imissyou6534/cheshire/docs/current_soc_architecture_report.html

# Cheshire CVA6 + Ara + FFT / VCU118 SoC 架构与地址空间分析

分析对象：/home/user06/work/xinkailai/cheshire，分支 ara-vcu118，当前工作区包含未提交的 FFT/VCU118 相关改动。

生成日期：2026-10-03。本文只基于当前源码与已生成脚本做静态分析；没有修改 RTL、C 源码或构建脚本。

## 1. 结论摘要

### SoC 主体

顶层 SoC 是 hw/cheshire_soc.sv。它以 CVA6 为核心，通过一个主 AXI crossbar 连接调试模块、LLC/SPM、DMA、Ara、FFT、VGA/USB 等 AXI master 或 slave，再通过 AXI-to-Regbus 适配器访问低速外设。

### VCU118 封装

板级顶层是 target/xilinx/src/cheshire_top_xilinx.sv。VCU118 打开 DDR4、JTAG、QSPI/STARTUPE3、VIO 和 reset；DDR4 通过 dram_wrapper_xilinx.sv 接到 SoC 的 LLC 外部 AXI master 端口。

### 地址分配

地址空间由 hw/cheshire_pkg.sv 中的 gen_axi_out() 和 gen_reg_out() 生成；实际译码在 hw/cheshire_soc.sv 的 axi_xbar 与 addr_decode + reg_demux 中完成。

### FFT 集成方式

FFT 不是 MMIO 外设，没有单独寄存器窗口。它复用 CVA6 的 accelerator/CVXIF 类接口，与 Ara 通过 multi_accel_router 按指令 opcode 分流，并作为独立 AXI master 访问现有内存地址。

当前构建脚本状态：target/xilinx/scripts/add_sources.vcu118.tcl 当前定义了 ARA、NR_LANES=2、VLEN=2048，但没有定义 FFT_ACCEL。源码已经有 Cfg.Fft、FFT RTL 和路由逻辑；若要在 VCU118 bitstream 中实际实例化 FFT，需要确保构建时带上 FFT_ACCEL 宏并重新生成/使用对应 Vivado source script。

## 2. 当前 VCU118 配置来源

配置链路如下：

1. hw/cheshire_pkg.sv 定义 cheshire_cfg_t、DefaultCfg、地址常量和地址映射函数。
2. target/xilinx/src/cheshire_top_xilinx.sv 的 gen_cheshire_xilinx_cfg() 从 DefaultCfg 复制配置，并针对 FPGA 覆盖少量参数。
3. target/xilinx/src/phy_definitions.svh 根据 TARGET_VCU118 打开板级 IO 宏。
4. cheshire_soc #(.Cfg(FPGACfg)) 接收最终配置，内部生成 AXI/Regbus 端口数量和地址规则。

### 2.1 FPGA 顶层覆盖项

项目 | 当前值/行为 | 定义位置 | 说明
RTC | RtcFreq = 1_000_000 | cheshire_top_xilinx.sv | 50 MHz SoC 时钟分频得到 1 MHz RTC。
Serial Link | SerialLink = 0 | cheshire_top_xilinx.sv | 默认配置中打开，但 Xilinx 顶层显式关闭。
USB | VCU118 下通常为 0 | phy_definitions.svh + cheshire_top_xilinx.sv | 只有定义 USE_USB 时才置 ret.Usb = 1；VCU118 宏未定义 USE_USB。
Ara | 由 ARA 宏控制 | cheshire_top_xilinx.sv | 当前生成的 VCU118 source script 已定义 ARA。
Ara 参数 | NR_LANES=2, VLEN=2048 | add_sources.vcu118.tcl | 这些宏传入 AraNrLanes 和 AraVLEN。
FFT | 由 FFT_ACCEL 宏控制 | cheshire_top_xilinx.sv | 源码支持 ret.Fft = 1；当前已生成 VCU118 tcl 尚未带此宏。

### 2.2 VCU118 板级 IO 宏

target/xilinx/src/phy_definitions.svh 对 TARGET_VCU118 定义：

`define USE_RESET
`define USE_JTAG
`define USE_DDR4
`define USE_QSPI
`define USE_STARTUPE3
`define USE_VIO

这表示板级已接出 reset、JTAG、DDR4、QSPI flash 访问路径和 VIO。I2C、SD、VGA、USB、fan 等宏没有在 VCU118 分支中打开。注意：这不等同于 SoC 内部外设配置全部关闭；例如 DefaultCfg 仍默认开启 I2C、GPIO、VGA，除非 FPGA 配置函数覆盖。

## 3. SoC 结构

### 3.1 高层数据通路

CVA6 core
  |-- AXI master ---------------------------------------------.
  |                                                           |
  |-- accelerator request --> multi_accel_router --> Ara ---- | --> AXI master
                         |                     \              |
                         `--------------------> FFT accel ----'

Debug SBA / DMA / VGA / USB / external AXI masters --------------> AXI xbar

AXI xbar outputs:
  [0] Debug Module AXI slave
  [1] AXI-to-Regbus adapter -> Reg demux -> CLINT/PLIC/UART/SPI/GPIO/...
  [2] LLC/SPM/DRAM path
  [3] DMA config AXI slave
  [external] optional AXI subordinate ports

LLC master output -> Xilinx DDR4 wrapper -> VCU118 DDR4 MIG

### 3.2 关键模块职责

模块/文件 | 职责 | 与地址空间关系
hw/cheshire_pkg.sv | 配置结构、默认配置、静态地址常量、AXI/Regbus 端口和规则生成函数。 | 地址分配的单一核心来源。
hw/cheshire_soc.sv | SoC 顶层，实例化 AXI crossbar、Regbus demux、CVA6、Ara、FFT、调试模块、外设。 | 把 AxiMap 接到 axi_xbar，把 RegMap 接到 addr_decode。
target/xilinx/src/cheshire_top_xilinx.sv | Xilinx/VCU118 顶层封装，产生时钟/reset，连接 DDR、JTAG、UART、QSPI 等板级 IO。 | 不重新定义 SoC 地址，只选择配置和连接外部 DRAM。
target/xilinx/src/dram_wrapper_xilinx.sv | Xilinx DDR3/DDR4 MIG AXI 包装。 | 接收 SoC 的 axi_llc_mst_req_o，承载 0x8000_0000..0x1_0000_0000 DRAM 区域。
hw/fft/src/*.sv | FFT 指令识别、Ara/FFT 请求路由、FFT 任务控制、AXI 读写桥和 FFT core 包装。 | 无 MMIO 窗口；通过 AXI master 对已有内存区域读写。
sw/link/common.ldh | 裸机软件的 linker 地址符号。 | 定义 __base_uart、__base_spm、__base_dram 等软件可见基址。

## 4. 地址空间如何分配

### 4.1 分配机制

Cheshire 的地址分配不是散落在外设实例化处手写的，而是由配置结构生成：

层级 | 函数/模块 | 输入 | 输出
AXI crossbar 输入端口 | gen_axi_in(Cfg) | 哪些 AXI manager 启用：core、debug、Ara、FFT、DMA、VGA、USB、external masters | AxiIn.* 端口编号
AXI crossbar 输出端口和规则 | gen_axi_out(Cfg) | LLC/SPM/DRAM/DMA/SerialLink/external rules | AxiOut.* 端口编号与 AxiMap
Regbus demux 输出端口和规则 | gen_reg_out(Cfg) | Boot ROM、CLINT、PLIC、UART、I2C、SPI、GPIO、VGA、BusErr 等开关 | RegOut.* 端口编号与 RegMap
实际译码 | axi_xbar, addr_decode, reg_demux | AxiMap, RegMap | 把访问请求送到具体 slave；Regbus 未命中进 error slave。

地址规则是半开区间：源码中用 start 和 pte/end_addr 表示 [start, end)。例如 0x0300_2000..0x0300_3000 是 4 KiB UART 窗口。

### 4.2 顶层 AXI 地址映射

以下按当前 VCU118 配置理解；若 FFT_ACCEL 打开，只增加 AXI manager 输入端口，不增加新的地址窗口。

地址范围 | 大小 | AXI 输出端口 | 目标 | 定义来源
0x0000_0000 .. 0x0004_0000 | 256 KiB | AxiOut.dbg | RISC-V Debug Module ROM/register/SBA slave | gen_axi_out(), AmDbg
0x0100_0000 .. 0x0100_1000 | 4 KiB | AxiOut.dma | iDMA 配置 slave | gen_axi_out()
0x0200_0000 .. 0x0c00_0000 | 160 MiB | AxiOut.reg_demux | AXI-to-Regbus 适配器，再二级译码到 Regbus 外设 | gen_axi_out()
0x1000_0000 .. 0x1002_0000 | 128 KiB | AxiOut.spm/AxiOut.llc | LLC scratchpad cached alias | get_llc_size(DefaultCfg)
0x1400_0000 .. 0x1402_0000 | 128 KiB | AxiOut.spm/AxiOut.llc | LLC scratchpad uncached alias | AmSpm + 0x0400_0000
0x8000_0000 .. 0x1_0000_0000 | 2 GiB | AxiOut.llc | LLC outgoing DRAM region，VCU118 接 DDR4 MIG | LlcOutRegionStart/End

文档与当前配置的差异：上游 docs/um/arch.md 用概念表描述 SPM 为 64 MiB cached + 64 MiB uncached；当前 DefaultCfg 的 LLC 参数计算得到实际内部 SPM 大小为 128 KiB，因此硬件 map 为 0x1000_0000..0x1002_0000 和 0x1400_0000..0x1402_0000。

### 4.3 Regbus 二级地址映射

地址范围 | 大小 | Regbus 端口 | 外设/模块 | 当前 VCU118 状态
0x0200_0000 .. 0x0204_0000 | 256 KiB | RegOut.bootrom | Boot ROM | 启用
0x0204_0000 .. 0x0208_0000 | 256 KiB | RegOut.clint | CLINT | 启用
0x0208_0000 .. 0x020c_0000 | 256 KiB | RegOut.irq_router | IRQ router | 当前配置关闭，访问落入 Regbus error slave
0x020c_0000 .. 0x0210_0000 | 256 KiB | RegOut.axirt | AXI RT | 当前配置关闭，访问落入 Regbus error slave
0x0300_0000 .. 0x0300_1000 | 4 KiB | RegOut.regs | Cheshire SoC registers | 启用
0x0300_1000 .. 0x0300_2000 | 4 KiB | RegOut.llc | LLC config | 启用
0x0300_2000 .. 0x0300_3000 | 4 KiB | RegOut.uart | UART | 启用并接到板级 UART
0x0300_3000 .. 0x0300_4000 | 4 KiB | RegOut.i2c | I2C host | SoC 配置启用；VCU118 顶层未定义 USE_I2C
0x0300_4000 .. 0x0300_5000 | 4 KiB | RegOut.spi_host | SPI host | 启用；VCU118 经 STARTUPE3 接 QSPI flash
0x0300_5000 .. 0x0300_6000 | 4 KiB | RegOut.gpio | GPIO | SoC 配置启用；VCU118 顶层未暴露 GPIO 端口
0x0300_6000 .. 0x0300_7000 | 4 KiB | RegOut.slink | Serial Link config | FPGA 配置关闭
0x0300_7000 .. 0x0300_8000 | 4 KiB | RegOut.vga | VGA config | SoC 配置启用；VCU118 顶层未定义 USE_VGA
0x0300_8000 .. 0x0300_9000 | 4 KiB | RegOut.usb | USB OHCI config | VCU118 当前配置关闭
0x0300_9000 .. 0x0300_9040 | 64 B | RegOut.bus_err[0] | VGA UNBENT bus error unit | 启用条件：Vga && BusErr
0x0300_9040 .. 0x0300_9080 | 64 B | RegOut.bus_err[1] | DMA UNBENT bus error unit | 启用条件：Dma && BusErr
0x0300_9080 .. 0x0300_90c0 | 64 B | RegOut.bus_err[2] | Core 0 UNBENT bus error unit | 启用条件：BusErr
0x0400_0000 .. 0x0800_0000 | 64 MiB | RegOut.plic | PLIC | 启用
0x0800_0000 .. 0x0804_0000 per core | 256 KiB/core | RegOut.clic[i] | CLIC | 当前配置关闭

### 4.4 软件 linker 可见基址

sw/link/common.ldh 把主要 MMIO 地址暴露成 C/汇编可引用的符号：

符号 | 值 | 含义
__base_dma | 0x0100_0000 | iDMA 配置
__base_bootrom | 0x0200_0000 | Boot ROM
__base_clint | 0x0204_0000 | CLINT
__base_axirt | 0x020c_0000 | AXI RT 配置
__base_regs | 0x0300_0000 | Cheshire SoC registers
__base_llc | 0x0300_1000 | LLC 配置
__base_uart | 0x0300_2000 | UART
__base_i2c | 0x0300_3000 | I2C
__base_spih | 0x0300_4000 | SPI host
__base_gpio | 0x0300_5000 | GPIO
__base_vga | 0x0300_7000 | VGA
__base_bus_err | 0x0300_9000 | UNBENT bus error units
__base_plic | 0x0400_0000 | PLIC
__base_clic | 0x0800_0000 | CLIC base
__base_spm | 0x1000_0000 | SPM cached alias
__base_dram | 0x8000_0000 | DRAM base

## 5. 外设在哪里定义

外设/功能 | 实例化位置 | 寄存器定义/头文件 | 地址来源
Debug Module + JTAG | hw/cheshire_soc.sv, dm_top, dmi_jtag | 依赖 riscv-dbg | AmDbg = 0x0000_0000
Boot ROM | hw/cheshire_soc.sv, hw/bootrom/cheshire_bootrom.sv | hw/bootrom/*.S, *.c | AmBrom = 0x0200_0000
SoC registers | hw/cheshire_soc.sv, cheshire_reg_top | hw/regs/cheshire_regs.hjson, generated hw/regs/cheshire_reg_pkg.sv, sw/include/regs/cheshire.h | AmRegs = 0x0300_0000
CLINT | hw/cheshire_soc.sv, clint | sw/include/regs/clint.h | 0x0204_0000
PLIC | hw/cheshire_soc.sv, rv_plic | OpenTitan peripherals generated package | 0x0400_0000
UART | hw/cheshire_soc.sv, reg_uart_wrap | sw/include/dif/uart.h | 0x0300_2000
I2C | hw/cheshire_soc.sv, OpenTitan i2c | sw/include/hal/i2c_24fc1025.h | 0x0300_3000
SPI host | hw/cheshire_soc.sv, OpenTitan spi_host | sw/include/hal/spi_s25fs512s.h, spi_sdcard.h | 0x0300_4000
GPIO | hw/cheshire_soc.sv, OpenTitan gpio | OpenTitan generated headers | 0x0300_5000
LLC/SPM | hw/cheshire_soc.sv, axi_llc_reg_wrap | sw/include/regs/axi_llc.h | 配置寄存器 0x0300_1000；数据窗口 0x1000_0000/0x1400_0000/0x8000_0000
iDMA | hw/cheshire_soc.sv, cheshire_idma_wrap | sw/include/regs/idma.h, sw/include/dif/dma.h | 0x0100_0000
VGA | hw/cheshire_soc.sv, axi_vga | sw/include/regs/axi_vga.h | 0x0300_7000
UNBENT bus error | hw/cheshire_soc.sv, axi_err_unit_wrap | 依赖 unbent | 0x0300_9000 起，每个 unit 64 B
Ara | hw/cheshire_soc.sv, ara | 依赖 ara repo | 无 MMIO；使用 CVA6 accelerator 接口 + AXI master
FFT | hw/fft/src/*.sv，在 hw/cheshire_soc.sv 中条件实例化 | sw/tests/fft_accel_*.spm.c 使用自定义指令 | 无 MMIO；使用 CVA6 accelerator 接口 + AXI master

## 6. Ara 与 FFT 共享接口分析

### 6.1 CVA6 accelerator 接口路径

CVA6 输出 cvxif_req_o，输入 cvxif_resp_i。原始 Ara 集成通常直接把这组信号接到 Ara；当前分支加入了 multi_accel_router：

CVA6 cvxif_req_o
  -> acc_req
  -> multi_accel_router
      if FFT namespace: acc_req_fft -> fft_accelerator_ip
      else:             acc_req_ara -> ara
  <- acc_resp from selected unit
  -> acc_resp_pack -> CVA6 cvxif_resp_i

### 6.2 指令分流规则

hw/fft/src/fft_accel_pkg.sv 定义了 FFT 指令命名空间：

类别 | 规则 | 用途
FFT start | opcode = 0x0b, funct3 = 0x5, insn[30:25] = 12, rd = x0 | 从 rs1 取源地址，从 rs2 取目标地址，启动 4096 点 FFT/IFFT。
FFT/IFFT 选择 | insn[31] | 作为 inverse 位传给 FFT core。
FFT wait | 0x0000_002b | 等待当前 FFT epoch 完成，返回异常状态。
Ara | 不属于 FFT namespace 的 accelerator 请求 | 转发给 Ara。

### 6.3 FFT 数据搬运

fft_accelerator_ip 内部包含命令队列、fft_task_ctrl、axi_from_mem 和 fftifftmain：

- rs1 是输入 buffer 地址，rs2 是输出 buffer 地址。
- fft_task_ctrl 固定处理 Points = 4096。
- 当前 DataWidth = 64，每拍从内存读 4 个 16-bit 样本。
- 输入样本打包为 {real16, 16'h0} 送入 FFT core。
- 输出把 23-bit real/imag 符号扩展后打成 64-bit 写回内存。
- AXI 请求经 axi_from_mem 发到主 AXI crossbar，因此可访问 SPM uncached alias、DRAM 等已有 AXI 地址。

### 6.4 软件调用方式

sw/tests/fft_accel_smoke.spm.c 和 fft_accel_dump.spm.c 使用内联汇编发自定义指令。测试中使用 SPM_UNCACHED_ALIAS = 0x04000000 把 0x1000_0000 附近的 SPM cached 地址转换到 0x1400_0000 uncached alias，减少缓存一致性干扰。

fft_exec(src, dst):  .insn r 0x0b, 0x5, 0x0c, x0, rs1, rs2
ifft_exec(src, dst): .insn r 0x0b, 0x5, 0x4c, x0, rs1, rs2
fft_wait():          .word 0x0000002b

## 7. AXI 端口编号推导

按当前 VCU118 + Ara + FFT 设计意图推导，gen_axi_in() 的输入端口顺序如下。若 FFT_ACCEL 未实际定义，则 fft 端口不存在，后续 DMA/VGA 端口编号前移。

AXI input index | FFT 打开时 | FFT 未打开时 | 说明
0 | Core 0 | Core 0 | CVA6 普通取指/访存 AXI master。
1 | Debug SBA | Debug SBA | Debug Module system bus access。
2 | Ara | Ara | Ara AXI master，经 data-width converter 后进入 xbar。
3 | FFT | DMA | FFT 打开后新增独立 AXI master。
4 | DMA | VGA | iDMA 数据搬运 AXI master。
5 | VGA | external base | VGA frame fetch AXI master。
6 | external base | - | 当前 AxiExtNumMst = 0，没有外部 master。

输出端口在当前配置下大致为：

AXI output index | 名称 | 地址规则
0 | dbg | 0x0000_0000..0x0004_0000
1 | reg_demux | 0x0200_0000..0x0c00_0000
2 | llc/spm | 0x1000_0000..0x1002_0000, 0x1400_0000..0x1402_0000, 0x8000_0000..0x1_0000_0000
3 | dma | 0x0100_0000..0x0100_1000

## 8. 注意事项与风险点

项目 | 说明 | 建议
FFT 宏未进入已生成脚本 | add_sources.vcu118.tcl 未包含 FFT_ACCEL，所以当前已生成 Vivado 工程脚本可能只启用 Ara。 | 重新生成 Bender Vivado script 或在构建流中显式加入 FFT_ACCEL，再确认 FPGACfg.Fft = 1。
FFT 无 MMIO 可见性 | SoC registers 的 hw_features 当前没有 fft bit；软件无法通过该寄存器确认 FFT 是否存在。 | 如果需要运行时探测，可考虑扩展 cheshire_regs.hjson，但这属于后续源码修改。
VCU118 板级 IO 与 SoC 内部配置不完全一致 | I2C/GPIO/VGA 可能在 SoC 内部仍实例化并有地址窗口，但 VCU118 顶层没有完整板级 IO。 | 区分“MMIO 可访问”和“外设信号接到板上”。文档、bring-up 和测试脚本中应按板级可用性选择外设。
Ara/FFT 共享 accelerator 接口的互斥 | multi_accel_router 使用 pending owner 保证同一请求等待对应响应；FFT namespace 外的请求转给 Ara。 | 混合运行 RVV 和 FFT 时，应继续覆盖背靠背请求、异常、wait、fence/cache 场景。
FFT 与缓存一致性 | FFT AXI master 直接读写内存；测试使用 SPM uncached alias 和 fence。 | 软件侧继续优先使用 uncached alias 或明确 cache maintenance/一致性策略。

## 9. 参考文件清单

文件 | 用途
hw/cheshire_pkg.sv | 配置结构、默认配置、地址常量、AXI/Regbus map 生成。
hw/cheshire_soc.sv | SoC 主体、AXI xbar、Regbus demux、CVA6/Ara/FFT/外设实例化。
target/xilinx/src/cheshire_top_xilinx.sv | VCU118/VCU128/Genesys2 顶层封装和 FPGA 配置覆盖。
target/xilinx/src/phy_definitions.svh | 按 FPGA 板卡定义可用 IO 宏。
target/xilinx/scripts/add_sources.vcu118.tcl | 当前已生成 VCU118 Vivado source script 和宏列表。
Bender.yml | 依赖与 RTL source 列表；当前已加入 FFT source 文件。
cheshire.mk | Bender RTL flags；当前加入 exclude_first_pass_decoder target。
hw/fft/src/fft_accel_pkg.sv | FFT 自定义指令编码和识别函数。
hw/fft/src/multi_accel_router.sv | Ara/FFT accelerator 请求分流。
hw/fft/src/fft_accelerator_ip.sv | FFT accelerator 顶层、命令队列、AXI bridge。
hw/fft/src/fft_task_ctrl.sv | 4096 点 FFT 数据读、喂入、结果写回状态机。
sw/link/common.ldh | 软件 linker 可见地址符号。
sw/tests/fft_accel_smoke.spm.c | FFT smoke test，自定义指令调用示例。
