imissyou6534/cheshire/docs/cheshire_idma_scheme_b_architecture_rtl_design.html

CHESHIRE · IDMA v0.6.3 · RTL ARCHITECTURE NOTE / 2026-10-12

# 多 Tile 共享多个 iDMA 方案 B：一次 MMIO → 原生 ND Job → 多 Backend

对照原始 Cheshire/iDMA RTL，给出 N Tile / M DMA 的系统级控制面、执行面、寄存器、调度、ND 多维握手、DDR AXI 互连、源码改造清单和验证策略。

参考：4 Tile × 2 iDMA × 1 DDR控制面与数据面解耦不重复编程第二级 DMA MMIO基于固定 iDMA Git revision

01 / OVERVIEW

## 设计范围与核心决策

方案 B = 每 Tile 只做一轮 MMIO 配置，提交时硬件形成不可变的 idma_nd_req_t，经 Job FIFO 和 Scheduler 交给多个独立的 iDMA ND Midend + AXI Backend 执行。没有第二次 DMA MMIO 编程。

N独立 Cheshire Tile / CSR 上下文

M共享 DMA Engine / AXI Master

1全局 DDR 控制器

0执行端重复 MMIO 配置

### 实现约定（2026-10-12 修订）

- NumTiles 和 NumDmas 为独立的综合/elaboration 参数，默认 4×2，支持单路和非二次幂数量，并非运行时热插拔。
- 每 Tile 一个 CVA6 和私有资源；DMA 仅访问配置的全局 DDR 范围。
- 各 Tile 使用相同的本地 MMIO 地址 0x0100_0000，按物理端口隔离 CSR。
- 每 Tile 和每 Engine 最多一个执行中顶层 ND Job；同 Tile 可排队并按序完成，不同 Tile 并行且可乱序完成。
- Tile、Pool、Fabric 使用统一时钟及协调复位。独立热复位、自动取消、超时回收不在首版范围。
- 使用 B2 CSR 和 sw/include/shared_dma.h；不兼容旧 NEXT_ID 读触发驱动。

实际源码：hw/shared_dma/ 包含 CSR、Scheduler、Engine、Pool、DDR Fabric、Subsystem、配置包及 multi_tile_top.sv；target/sim/src/tb_shared_dma.sv 与 util/run_shared_dma_tests.sh 为自校验仿真入口。下文接口草案解释原理，实际端口以这些源码为准。

请区分“软件配置一次”与“只发一次 MMIO 事务”。CPU 仍可能写 SRC、DST、LEN、CONF、Stride、Reps 等多个寄存器；这些写操作只有一轮。CPU 触发 Submit 后，Scheduler → ND Midend 走硬件 valid/ready，不是第二轮寄存器写入。

02 / TOPOLOGY

## 推荐顶层结构及两张互连网络

蓝色为 MMIO 控制、任务与完成通路；绿色为 DMA 数据 AXI 与 DDR。不同 Tile 的 DDR Master 也进入 Global AXI Xbar。

### 控制网络与数据网络完全分开

网络 | 主设备 → 从设备 | 性质 | 是否共享带宽
DMA 控制网络 | 每个 `cheshire_soc.axi_ext_slv_req_o[i]` → 对应 CSR Bank | 32-bit MMIO 配置；Job 控制、完成读取 | 每 Tile 私有控制入口
Job 分发网络 | N 个 Job FIFO → Scheduler → M 个 Engine | `idma_nd_req_t` + Owner 元数据，valid/ready | 共享调度资源
DDR 数据网络 | N 个 Tile DDR Master + M 个 DMA AXI Master → DDR | AXI AR/R + AW/W/B，正常 DDR 流量 | 所有参与者共享 DDR 吞吐

每个 CPU 的 MMIO 写入不会直接交给同一个原始 DMA 寄存器组，而是写入由物理端口识别的 CSR Bank[i]。不同 Tile 的多次写入即使交错，也不会覆盖彼此的 SRC/DST/LEN。

03 / BASELINE

## 原始源码分析：哪些已有，哪些没有

### 原始 `cheshire_idma_wrap.sv` 数据路径

textCPU MMIO → AXI Slave → axi_to_reg
         → idma_reg64_2d (NumRegs=1, NumStreams=1)
         → stream_fifo_optimal_wrap (ND Job FIFO)
         → idma_nd_midend (NumDim=2)
         → idma_backend_rw_axi
         → axi_rw_join → AXI Master → DDR

环节 | 原始 Cheshire (`Cfg.Dma=1`) | 方案 B (`Cfg.Dma=0`)
控制入口 | 单个内部 DMA AXI Slave；单个 `axi_to_reg` | 每 Tile 外部 MMIO AXI Slave → 独立 `axi_to_reg`
配置上下文 | 单个 `idma_reg64_2d`，`NumRegs=1` | N 个独立 CSR Bank；可复用 N 个 `NumRegs=1` 前端
队列 | 一个 `stream_fifo_optimal_wrap` | N 个 Tagged Job FIFO；带来源/任务编号
分配层 | 无 N→M Job Scheduler | 新增全局 N→M Scheduler / owner 管理
多维转换 | 一个 `idma_nd_midend` | M 个独立 `idma_nd_midend`
数据搬运 | 一个 `idma_backend_rw_axi` | M 个原样复用的 `idma_backend_rw_axi`
AXI 主端 | 一个 `axi_rw_join` 输出 | M 个 AXI Master 汇入 DDR Global Xbar
完成 | 单个 `idma_transfer_id_gen` | 每 Tile Job ID、Completion/IRQ、必要时按序重排

源码锁定版本：Cheshire 的原始 wrapper (https://github.com/pulp-platform/cheshire/blob/mp/ara-pulp-v2/hw/cheshire_idma_wrap.sv) 使用 NumDim=2、TfLenWidth=32、RepWidth=32、一个前端与一个 Backend；2D 模式 Job FIFO 存储 idma_nd_req_t，ND Midend 输出 idma_req_t 子请求。

可直接借鉴的同版本参考：`idma_inst64_top.sv` (https://github.com/pulp-platform/iDMA/blob/c12caf59bb482fe44b27361f6924ad346b2d22fe/src/frontend/inst64/idma_inst64_top.sv) 在 NumChannels 循环中实例化了多个 Backend、ND Midend 与 AXI RW Join。它的 Frontend 不同，但多执行通道的组织方式可以参考。

04 / SOC PORTS

## Cheshire 现有接口如何复用

`cheshire_soc` 接口 | 在方案 B 中的用途 | 是否需要新加 Tile AXI 接口
`axi_ext_slv_req_o` / `axi_ext_slv_rsp_i` | CPU 发出的外部 MMIO 请求，直连对应 Tile 的 CSR Bank | 否。使用已有外部从设备输出口
`axi_llc_mst_req_o` / `axi_llc_mst_rsp_i` | Tile 的共享 DDR 访问主端口，接 Global AXI Xbar | 否，使用已有 DDR 外部主端口
`axi_ext_mst_req_i` / `axi_ext_mst_rsp_o` | 外部设备主动访问 Tile 内部资源 | DDR→DDR 不需要启用；只有访问 Tile 私有存储器才讨论

### 推荐 Tile 配置

systemverilog// 参数字段示意；应在配置对象初始化后赋值
TileCfg.NumCores         = 1;
TileCfg.Dma              = 0;  // Tile 内不产生原始 iDMA
TileCfg.AxiExtNumSlv     = 1;  // 向 Tile 外部 CSR 发 MMIO
TileCfg.AxiExtNumRules   = 1;
TileCfg.AxiExtRegionIdx[0]   = 0;
TileCfg.AxiExtRegionStart[0] = 64'h0000_0000_0100_0000;
TileCfg.AxiExtRegionEnd[0]   = 64'h0000_0000_0100_1000;

// 建议初始验证 LLC bypass，需保留 DDR 出口
TileCfg.LlcOutConnect = 1;
TileCfg.LlcNotBypass  = 0;

上述外部地址映射遵循 `gen_axi_out()` (https://github.com/pulp-platform/cheshire/blob/mp/ara-pulp-v2/hw/cheshire_pkg.sv)：当 Cfg.Dma=1 时内部 DMA 占用 0x0100_0000–0x0100_1000，关闭后可经 AxiExtRegion* 将同一段地址指向外部 CSR。axi_llc_mst_req_o 必须由 LLC/Bypass 路径正确接出。

注意地址域：四个 Tile 内相同 MMIO 地址通过不同的物理控制端口映射到四份 CSR。它们并非一个全局唯一物理 AXI 地址上的单一寄存器组。Tile 私有程序地址也应继续在各 Tile 内部独立解码。

05 / MMIO REGISTERS

## 每 Tile MMIO CSR：兼容模式与推荐模式

### 原版 iDMA v0.6.3 的关键寄存器

相对偏移 | 寄存器 | 访问 | 意义
0x000 | CONF | R/W | 解耦、Burst 控制、ENABLE_ND；保留旧布局
0x004 | STATUS_0 | RO | 当前流状态（后续可扩展成 Pool 状态）
0x044 | NEXT_ID_0 | 原版读触发 | 若兼容旧驱动，读取时提交 Job
0x084 | DONE_ID_0 | RO | 旧版累计完成序号；跨 Engine 乱序需按序修复
0x0D0 / 0x0D4 | DST_ADDR LOW/HIGH | R/W | 64 位目的地址
0x0D8 / 0x0DC | SRC_ADDR LOW/HIGH | R/W | 64 位源地址
0x0E0 / 0x0E4 | LENGTH LOW/HIGH | R/W | 传输长度；当前 Backend 集成有效宽度需限制为 32bit
0x0E8 / 0x0EC | DST_STRIDE_2 LOW/HIGH | R/W | 二维目标地址步长
0x0F0 / 0x0F4 | SRC_STRIDE_2 LOW/HIGH | R/W | 二维源地址步长
0x0F8 / 0x0FC | REPS_2 LOW/HIGH | R/W | 二维重复次数

生成头文件：`sw/include/regs/idma.h` (https://github.com/pulp-platform/cheshire/blob/mp/ara-pulp-v2/sw/include/regs/idma.h)。该头文件也声明 16 个 STATUS_n / NEXT_ID_n / DONE_ID_n 槽位；但当前 Cheshire NumStreams=1，实际使用的是第 0 路。

#### 方式 B1｜保留原版 MMIO 兼容

每 Tile 放一份 idma_reg64_2d(NumRegs=1)，把它的 idma_nd_req_t + valid/ready 接外部 Job FIFO；NEXT_ID 读触发；每 Tile 新增独立的 next_id / done_id 维护逻辑。

优点：旧驱动改动小。风险：读触发副作用、满队列反压、完成顺序对接复杂，必须逐项验证。

#### 方式 B2｜自定义 Pool CSR（推荐正式版）

仍只在每 Tile 配置一次 MMIO；新增写触发 SUBMIT、队列容量、Completion；由 dma_tile_csr 直接构造 idma_nd_req_t。

优点：状态语义清晰，支持错误和乱序完成。代价：需要适配新的驱动。

### 已实现的 B2 Pool CSR（新增接口）

偏移 | 寄存器 | 语义
0x100 | POOL_SUBMIT (W) | byte0有效且bit0=1：快照、分配ID、入队、预留完成容量；满或非法立即SLVERR，ID不变
0x104 | POOL_Q_STATUS (R) | bit0=可接受；[15:8]=已提交但未POP数量；[23:16]=剩余完成容量，不是Job FIFO occupancy
0x108 | POOL_COMP_VALID (R) | bit0=当前Tile完成队首有效
0x10C | POOL_COMP_JOB_ID (R) | 32-bit ID，保持至POP；首笔ID=1，允许自然回绕
0x110 | POOL_COMP_STATUS (R) | [7:0]=0成功/1读错误/2写错误/3内部非法；[31:16]=Engine ID
0x114 | POOL_COMP_POP (W) | byte0有效且bit0=1：消费队首并归还容量；空队列无副作用
0x118 | POOL_IRQ_ENABLE (R/W) | bit0=完成队列非空时的电平IRQ使能
0x11C | POOL_LAST_JOB_ID (R) | 最近成功提交ID；失败不改变
0x120 | POOL_SUBMIT_STATUS (R) | [7:0]=最近提交结果：0成功/3参数非法/4容量不足

修正阻塞提交死锁：完成容量耗尽时，CPU仍须读Completion并POP，因此SUBMIT不得无限等待。驱动先检查Q_STATUS；容量不足由软件重试。同Tile多个提交者须对检查、配置、SUBMIT及取ID整个序列互斥。非法裸MMIO提交产生SLVERR，CPU如何上报取决于适配器及异常路径；驱动还须检查SUBMIT_STATUS，不能仅依赖CPU异常。

建议在 POOL_SUBMIT 的写响应完成时，确保 Job 已入 FIFO 且完成容量已被预留；LAST_JOB_ID 可供单 CPU 顺序提交后读取。若同一 Tile 内增加多个并发软件提交者，则需再提供事务化分配接口或软件互斥。

06 / ATOMIC JOB

## MMIO 到 Job：原子化配置快照

CSR Bank 中的 SRC/DST/LENGTH 等属于可修改的 Shadow Registers。每次提交必须把整套参数原子复制为不可变 tagged_job_t。之后 CPU 可以写下一笔参数，旧 Job 完全不受影响。

systemverilog// 公共类型包中的示意声明；具体 typedef 由同版本宏生成
localparam int TileIdW = (NumTiles > 1) ? $clog2(NumTiles) : 1;
localparam int DmaIdW  = (NumDmas  > 1) ? $clog2(NumDmas)  : 1;

typedef struct packed {
  logic [TileIdW-1:0] tile_id;  // 来源于物理输入端口
  logic [31:0]        job_id;   // 本 Tile 独立分配
  idma_nd_req_t       nd_req;   // 原版 iDMA 多维请求结构
} tagged_job_t;

typedef struct packed {
  logic [31:0]        job_id;
  logic [DmaIdW-1:0]  engine_id;
  logic               error;
  logic [7:0]         error_code;
} completion_t;

新的 CSR→ND 转换函数至少要构造：burst_req.src_addr、dst_addr、length、AXI Burst/Cache/Protocol 及 Backend 选项；二维时还有 d_req[0].reps、src_strides 和 dst_strides。这些字段与 原版生成前端的转换逻辑 (https://github.com/pulp-platform/iDMA/blob/c12caf59bb482fe44b27361f6924ad346b2d22fe/src/frontend/reg/tpl/idma_reg.sv.tpl) 对照实现，不能只填地址和长度而放任其他字段为未定义值。

### 提交原子性要求

条件 | 动作 | 禁止行为
参数有效、Job FIFO与完成容量足够 | 快照入队、分配ID、预留完成容量 | 重复入队或仅分配ID未入队
FIFO或完成容量满 | 立即SLVERR，SUBMIT_STATUS=4 | 无限阻塞或静默丢Job
参数非法 | SLVERR，SUBMIT_STATUS=3，不分配ID或完成事件 | 截断高位后继续执行
提交后修改Shadow | 旧Job快照不变 | 修改队列任务

参数校验：长度及二维重复数非零；长度、二维stride/reps高32位为0；地址不得超AXI宽度。128-bit中间算术计算整个二维包围范围，须完全位于[MemStart, MemEnd)，源/目的范围不能重叠。stride无符号，可为0；保守范围检查可能拒绝不相交的交错二维行。一维CONF.ENABLE_ND=0时归一化REPS=1。

必须特别处理低/高 32 位配置写：CPU 先写 LOW 再写 HIGH（或者反过来）在提交前均可；Submit 前才统一取快照。使用设备属性、访问排序和 fence iorw, iorw 等保证参数在提交前可见。

07 / SCHEDULER

## N → M Scheduler：任务级仲裁而不是寄存器级仲裁

### 调度单元的唯一输入是完整 Job

systemverilog// 逻辑握手约定（不是可直接综合的完整 Scheduler）
input  tagged_job_t [NumTiles-1:0] tile_job_i;
input  logic        [NumTiles-1:0] tile_job_valid_i;
output logic        [NumTiles-1:0] tile_job_ready_o;

output tagged_job_t [NumDmas-1:0]  engine_job_o;
output logic        [NumDmas-1:0] engine_job_valid_o;
input  logic        [NumDmas-1:0] engine_job_ready_i;

### 已实现调度策略

1. 筛选非空且无执行中Job的Tile。
2. Tile和空闲Engine均独立RR，每周期最多dispatch一笔。
3. Engine ready来自寄存的IDLE状态；内部grant仅发往ready Engine，握手、锁存和FIFO pop同时完成。此接口不是可任意反压的通用流仲裁器。
4. Engine持有(tile_id, job_id)至Completion入队后释放。统一复位首版不使用generation。

systemverilog// 单周期抽象：一笔任务的接纳必须同时完成两件事
assign dispatch_fire[d] = engine_job_valid_o[d] && engine_job_ready_i[d];

// dispatch_fire[d] 时：
// 1) 弹出被选中的 tile_job_fifo
// 2) 写入 engine_owner[d]
// 3) engine_wrap[d] 锁存完整 job
// 不能出现 pop 发生了但 Engine 没有锁存的情况

不要把 Backend 的 `req_ready` 直接等同于顶层 Engine 空闲。后端可能在已有 Job 仍未完成时继续接受 1D 子请求；Engine 只能在完整顶层 ND Response 被处理后释放。

### 公平性与次序

默认选择轮询 RR。为降低第一阶段复杂度，可加 tile_inflight[i]，令同一 Tile 最多有一个执行中的 Job；这仍允许不同 Tile 在不同 DMA 并行。后续如放开同一 Tile 多 Engine 并发，就必须处理跨 Engine 乱序完成。

08 / ENGINE

## Engine Wrapper：ND 握手与任务生命周期

每个 Engine 拥有自己的 Holding Register、ND Midend、Backend 和 AXI RW Join。Scheduler 把完整 Job 分配到 Engine 后，必须保持 Job 不变，直到该 Midend 处理完所有 1D 子请求。

systemverilog// 原始 idma_nd_midend.sv 的关键握手（v0.6.3）
assign nd_req_ready_o = last & nd_req_valid_i & burst_req_ready_i;

// 注意：该 ready 在最后一个 1D 子请求成功交付时才为真。
// 它不是「第一个周期立即收到了完整 ND Job」。

状态 | 行为 | 可否接收下一个顶层 Job
IDLE | 等待 Scheduler；锁存一笔完整 Job 及 Owner | 可以（仅在有效握手时）
EXPAND | 保持 `nd_req_valid=1`、`nd_req_i=hold_q.nd_req` 稳定，等待最终 ND 请求握手 | 不可以
WAIT_DONE | 全部 1D 子请求已送给 Backend，但数据仍可能在搬运 | 不可以
REPORT | 握手或排队完成记录；释放 Owner 之前须确保 Completion 不丢失 | 不可以
IDLE | 归属完成关闭后才能分配下一笔 Job | 可以

systemverilog// 关键控制片段：示意 RTL，需处理同周期 req/rsp 与复位
assign nd_req_i       = job_hold_q.nd_req;
assign nd_req_valid_i = (state_q == EXPAND);

wire nd_req_fire = nd_req_valid_i && nd_req_ready_o;
wire nd_rsp_fire = nd_rsp_valid_o && nd_rsp_ready_i;

// Job 存放于 holding register；直到 nd_req_fire 保持稳定。
// 完成只能看 nd_rsp_fire，不能用 nd_req_fire 替代。
// 若非法/零重复请求导致「req_fire + rsp_fire 同周期」，也必须记录 Completion。

响应边界特别重要：原版 ND Midend 以 Backend 响应的 last 产生顶层 nd_rsp_valid_o；零重复的异常路径可能在输入完成握手附近立即返回错误响应。不能在状态机的 EXPAND 阶段忽略 nd_rsp_valid_o。

对于每个 Engine，继续原样使用 idma_backend_rw_axi 的内部缓存、Legalizer、AXI Read/Write Pipeline、AXI Burst 拆分；无须让 Backend 理解 tile_id 和 job_id。

09 / MULTIDIM

## 二维、多维 Job 如何展开及完成

一个有效 2D Job → REPS₂ 个 1D 子请求 → 每个 1D 请求可能由 Backend 产生若干 AXI Burst → 整个 ND Job 完成时对上游只报告一次顶层 Completion。

### 示例：源行距与目标行距不同

字段 | 设定
SRC | 0x8000_0000
DST | 0x9000_0000
LENGTH | 64 bytes / 每行
REPS_2 | 4
SRC_STRIDE_2 | 128 bytes
DST_STRIDE_2 | 256 bytes

1D 子请求序号 | SRC | DST | 长度
0 | 0x8000_0000 | 0x9000_0000 | 64 B
1 | 0x8000_0080 | 0x9000_0100 | 64 B
2 | 0x8000_0100 | 0x9000_0200 | 64 B
3 | 0x8000_0180 | 0x9000_0300 | 64 B

总传输量为 64 × 4 = 256 bytes。四个 1D 子请求仍属于同一 Job，不应由外层 Scheduler 分到不同 Engine。iDMA `idma_nd_midend.sv` 用 d_req[0] 的 repetitions 和 stride 更新地址，并在最后一个请求上标记 opt.last。

零重复/零长度：提交前拒绝零长度及启用二维时的零重复；一维模式归一化REPS=1。上游ND零重复错误路径不用于正常提交。

10 / COMPLETION

## Completion 路由、乱序、信用额与复位

### 完成归属

Engine保存(tile_id, job_id)；Engine ID为实例编号。最终ND响应到来后进入REPORT，完成入队后才释放Owner。同Tile最多一个执行中Job，因此不同Engine不会同时竞争同一Tile完成入口。统一复位首版不使用generation。

systemverilog// Owner / Completion 示例（不修改 idma_backend_rw_axi）
engine_owner[1] = '{tile_id: 2, job_id: 15};

// Engine1 完成后：
completion_fifo[2].push('{job_id: 15, engine_id: 1,
                          error: engine_rsp.error,
                          error_code: mapped_error_code});

### 两种完成语义

方案 | 完成上报规则 | 限制
新 Completion FIFO（首选） | 每次完成送 `(job_id, status, engine_id)`；可乱序 | CPU 要按 Job ID 匹配，不是单一 done_id
兼容旧 `DONE_ID` | 每 Tile 只推进连续完成的 Job 编号 | 需要 per-Tile reorder buffer 或保证同 Tile 顺序执行

### 信用额、复位和错误边界

- 不变量：排队 + 执行/待报告 + 未读完成 ≤ CompletionDepth。SUBMIT预留，POP归还；REPORT保持至完成握手。
- 必须协调复位Tile、Pool、Fabric及DDR在途事务，或先quiesce；generation不能撤销已发DDR写入。独立热复位不支持。
- 软件超时不取消Job，不得立即复用buffer或强行释放Engine。
- 原版Backend仍使用NO_ERROR_HANDLING；Engine监测整个ND Job的AXI R/B真实握手RESP[1]，锁存首个错误至最终完成。同周期读写错误优先读错误。正常排空，无retry/abort；错误目标数据不可使用。
- 硬件检查共享DDR范围和源/目的重叠，不提供per-Tile安全隔离。

11 / DDR FABRIC

## 全局 AXI DDR 互连、ID、Cache 与时钟

### 总主端口数

DDR Fabric 至少接受 NumMasters = NumTiles + NumDmas 条逻辑 AXI Master。举例 4 Tile + 2 DMA = 6 路，各自带 AR/R/AW/W/B 五通道。Global Xbar 负责 AXI 仲裁、传输 ID 扩展和响应路由；不能用简单 MUX 代替。

systemverilog// 仅在所有输入 ID 宽度相同且采用源端编号前缀时的估算
GlobalAxiIdW >= LocalAxiIdW + $clog2(NumTiles + NumDmas);
// 4 Tile + 2 DMA → $clog2(6)=3 个源端编号位
// 真实配置需核对不同端口 ID 宽度和 DDR 控制器支持上限。

问题 | 建议
AXI 地址/数据/ID 类型 | 保证 Cheshire 的 `axi_ext_llc_*` 和 DMA 的 AXI Master 数据宽度/ID 兼容；必要时插入 width/id converter
DDR 争用 | AXI Xbar 中对 Tile 和 DMA 的 AR/AW 进行公平仲裁；允许背压与流水
Cache 一致性 | 外部 DMA 绕过 Tile LLC 时不保证自动一致；使用非缓存缓冲或严格 clean/invalidate + fence
AXI 原子操作与 DDR 约束 | 按 DDR 控制器规定处理 ATOP、Burst、4KiB 边界、写响应，不自动假定所有 AXI 功能可直通
时钟/复位域 | 优先所有控制/Engine 同一时钟域跑通；跨域需要 AXI/Job CDC 和 reset quiesce
私有 SRAM | 当前只允许全局 DDR；若要 DMA 访问 Tile 私有 SRAM，另设计入站访问/地址隔离/权限，不属于本版

12 / CHANGE LIST

## 原始工程如何修改：模块/文件级清单

文件 | 动作 | 说明
`hw/cheshire_soc.sv` | 尽量不改 | 每 Tile 配 `Cfg.Dma=0`，接既有 External AXI + DDR 端口
`hw/cheshire_pkg.sv` | 主要是配置参数化 | 配置 `AxiExtNumSlv` / `AxiExtNumRules` / LLC bypass
`hw/cheshire_idma_wrap.sv` | 不作为最终 Pool 顶层直接实例化 | 作为移植 typedef、Frontend/ND/Backend 连线和参数的参考
`shared_dma_pkg.sv` | 新增 | 统一 `tagged_job_t` / `completion_t` / 参数及宽度
`dma_tile_frontend.sv` | 新增封装 | `axi_to_reg` + per-Tile CSR 或单实例 `idma_reg64_2d`
`dma_job_fifo.sv` | 新增封装，复用 FIFO IP | 每 Tile Job 队列，原子快照
`dma_job_scheduler.sv` | 新增 | N→M Job 仲裁、Engine Owner、RR、Credit
`dma_engine_wrap.sv` | 新增封装 | Job Hold + M 个 ND Midend/Backend/RW Join
`dma_completion_router.sv` | 新增 | 每 Tile 完成/IRQ，generation 与异常管理
`shared_dma_pool.sv` | 新增 | N 套控制入口、M 套 DDR AXI 输出
`global_ddr_fabric.sv` | 新增集成 | PULP AXI Crossbar/必要的协议适配器
`multi_tile_top.sv` | 新增/改动最外层 | N 个 Cheshire + shared_dma_pool + DDR 控制器

### 建议目录结构

texthw/
├── multi_tile_top.sv
├── shared_dma_pool.sv
├── shared_dma_pkg.sv
├── dma_tile_frontend.sv
├── dma_job_scheduler.sv
├── dma_engine_wrap.sv
├── dma_completion_router.sv
└── global_ddr_fabric.sv

# 原有 IP 继续通过 Bender 依赖：
# axi_to_reg / stream_fifo_optimal_wrap
# idma_nd_midend / idma_backend_rw_axi / axi_rw_join

实际文件：全部新RTL位于hw/shared_dma/；FIFO及完成路由直接复用/组合现有IP。cheshire_shared_dma_cfg_pkg.sv生成独立多Tile配置，cheshire_shared_dma_subsystem.sv连接控制口、CPU数据口和DMA数据口。Bender.yml登记全部文件。

必须修正的上游问题：iDMA 0.6.3的idma_legalizer_rw_axi.sv及生成模板将页字节数PageSize传给位宽参数PageAddrWidth，跨页大块仿真出现地址跳跃和丢数据。util/patches/idma-0.6.3-page-width.patch改为实际位宽；util/prepare_shared_dma_deps.sh幂等应用，测试脚本和Make仿真入口均接入。重新checkout依赖后也必须应用此补丁。

共享DDR原子操作：cheshire_soc新增默认关闭的LlcSharedAtomics参数，多Tile顶层启用以绕过私有LLC AMO/LRSC处理。全局Xbar启用ATOP，之后统一axi_riscv_atomics_structs观察全部CPU/DMA写入。内部USER扩展携带物理主端口编号 + 本地hart标识作为reservation key，AXI响应ID不变，DDR出口USER恢复原宽度。仅设置LLC bypass不能解决跨Tile原子性。util/patches/另含LRSC计数宽度和寄存器非阻塞赋值补丁，修复256-beat写入漏清reservation及状态更新竞争；由同一个依赖准备脚本应用。

13 / RTL SKELETON

## SystemVerilog 接口草案与关键代码

### `shared_dma_pool.sv` 顶层建议

systemverilogmodule shared_dma_pool #(
  parameter int unsigned NumTiles = 4,
  parameter int unsigned NumDmas  = 2,
  parameter type tile_axi_req_t = logic,
  parameter type tile_axi_rsp_t = logic,
  parameter type dma_axi_req_t  = logic,
  parameter type dma_axi_rsp_t  = logic
) (
  input  logic clk_i,
  input  logic rst_ni,
  input  logic testmode_i,

  // 物理输入端口序号即可信 Tile ID
  input  tile_axi_req_t [NumTiles-1:0] tile_ctrl_req_i,
  output tile_axi_rsp_t [NumTiles-1:0] tile_ctrl_rsp_o,

  // M 个原始 DMA AXI 数据主端口
  output dma_axi_req_t [NumDmas-1:0] dma_axi_req_o,
  input  dma_axi_rsp_t [NumDmas-1:0] dma_axi_rsp_i,

  output logic [NumTiles-1:0] dma_irq_o
);
  // N: axi_to_reg + CSR + Job FIFO + Completion FIFO
  // 1: Round-Robin Scheduler / Credits / Owner table
  // M: Job Hold + ND Midend + Backend + axi_rw_join
endmodule

### Engine Wrapper 中最关键的连接

systemverilog// 结构示意：信号宽度、AXI 类型和模块完整参数省略
// 独占一个 Job 时，hold_q.nd_req 保持不变
idma_nd_midend #(
  .NumDim        (2),
  .addr_t        (addr_t),
  .idma_req_t    (idma_req_t),
  .idma_rsp_t    (idma_rsp_t),
  .idma_nd_req_t (idma_nd_req_t),
  .RepWidths     (RepWidth)
) i_nd (
  .clk_i, .rst_ni,
  .nd_req_i         (job_hold_q.nd_req),
  .nd_req_valid_i   (nd_valid),
  .nd_req_ready_o   (nd_ready),
  .nd_rsp_o         (nd_rsp),
  .nd_rsp_valid_o   (nd_rsp_valid),
  .nd_rsp_ready_i   (nd_rsp_ready),
  .burst_req_o      (burst_req),
  .burst_req_valid_o(burst_valid),
  .burst_req_ready_i(burst_ready),
  .burst_rsp_i      (burst_rsp),
  .burst_rsp_valid_i(burst_rsp_valid),
  .burst_rsp_ready_o(burst_rsp_ready),
  .busy_o           (midend_busy)
);

// burst_req + burst_valid/ready → 原版 idma_backend_rw_axi
// Backend AXI Read/Write → 原版 axi_rw_join → DDR Master
// 完成要等 nd_rsp_valid && nd_rsp_ready

### 建议的核心 SVA 检查点（伪代码）

systemverilog// 后端对当前 ND 请求反压时，数据/valid 必须稳定
property p_nd_hold_when_stalled;
  @(posedge clk_i) disable iff (!rst_ni)
    nd_valid && !nd_ready |=> nd_valid && $stable(nd_req);
endproperty
assert property (p_nd_hold_when_stalled);

// 顶层应另验证：每成功提交一个 Job → 恰好入队一次
// Engine Busy 期间 Owner 不会被覆盖
// 每个完成 Job 恰好报告一次，且来源 Tile/Job 不变
// 完成 FIFO 满时不能丢失或重复响应

代码定位：上述为接口、逻辑约束与移植草案，不是已经通过 Verilator、Bender 和 RTL 仿真的交付实现。生成实际可编译代码时，请按锁定版本 typedef 与实例端口列表补全。

14 / SOFTWARE

## CPU 提交一次 DDR→DDR Job：裸机软件草案

以下示例使用方案 B2 建议的 Pool MMIO，不是原始 idma_reg64_2d 的现成驱动。每个 Tile 的 CPU 都使用同一个数值 DMA_BASE，因为输出端口物理独立。

c#include <stdint.h>
#define DMA_BASE           0x01000000UL
#define REG_CONF           0x000
#define REG_DST_LO         0x0D0
#define REG_DST_HI         0x0D4
#define REG_SRC_LO         0x0D8
#define REG_SRC_HI         0x0DC
#define REG_LEN_LO         0x0E0
#define REG_LEN_HI         0x0E4
#define REG_DSTRIDE_LO     0x0E8
#define REG_DSTRIDE_HI     0x0EC
#define REG_SSTRIDE_LO     0x0F0
#define REG_SSTRIDE_HI     0x0F4
#define REG_REPS_LO        0x0F8
#define REG_REPS_HI        0x0FC
#define REG_POOL_SUBMIT    0x100  // 新增，而非原版 iDMA
#define REG_COMP_VALID     0x108
#define REG_COMP_JOB_ID    0x10C
#define REG_COMP_STATUS    0x110
#define REG_COMP_POP       0x114
#define REG_LAST_JOB_ID    0x11C
#define REG_Q_STATUS       0x104
#define REG_SUBMIT_STATUS  0x120

static inline void wr(uint32_t off, uint32_t v) {
  *(volatile uint32_t *)(DMA_BASE + off) = v;
}
static inline uint32_t rd(uint32_t off) {
  return *(volatile uint32_t *)(DMA_BASE + off);
}
static inline void wr64(uint32_t off, uint64_t val) {
  wr(off,   (uint32_t)val);
  wr(off+4, (uint32_t)(val >> 32));
}

uint32_t submit_ddr_copy(uint64_t src, uint64_t dst, uint32_t len) {
  // 此短例只支持默认DDR窗口，0表示失败；正式代码使用shared_dma_try_submit。
  if (!len || src >= 0x100000000ULL || dst >= 0x100000000ULL ||
      src < 0x80000000ULL || dst < 0x80000000ULL ||
      len > 0x100000000ULL-src || len > 0x100000000ULL-dst ||
      (src < dst+len && dst < src+len)) return 0;
  if (!(rd(REG_Q_STATUS) & 1)) return 0;
  wr64(REG_SRC_LO, src);
  wr64(REG_DST_LO, dst);
  wr(REG_LEN_LO, len); wr(REG_LEN_HI, 0);
  wr64(REG_SSTRIDE_LO, len);
  wr64(REG_DSTRIDE_LO, len);
  wr(REG_REPS_LO, 1); wr(REG_REPS_HI, 0);
  wr(REG_CONF, 1u << 10);   // 2D 前端，REPS=1 → 1 次 1D
  __asm__ volatile ("fence iorw, iorw" ::: "memory");
  wr(REG_POOL_SUBMIT, 1);   // 仅这一次新的外层提交；不再配置 Backend MMIO
  __asm__ volatile ("fence iorw, iorw" ::: "memory");
  if (rd(REG_SUBMIT_STATUS)) return 0;
  return rd(REG_LAST_JOB_ID);
}

// 示例：读完成队首，不对 NEXT_ID 做任何副作用读取
int poll_completion(uint32_t job_id) {
  for (uint32_t n = 0; n < 1000000; n++) {
    if (!rd(REG_COMP_VALID)) continue;
    uint32_t completed = rd(REG_COMP_JOB_ID);
    uint32_t status    = rd(REG_COMP_STATUS);
    wr(REG_COMP_POP, 1);
    if (completed == job_id) return status ? -2 : 0;
    // 多 Job 应用应存储其他 Job 的完成事件，避免误丢。
  }
  return -1;
}

正式驱动：sw/include/shared_dma.h提供shared_dma_try_submit(base, job, mem_start, mem_end, addr_width, id)及shared_dma_poll。返回0成功、-1容量不足、-2非法；地址窗口和位宽须匹配硬件。上面短例返回0失败且不能区分ID回绕，仅解释MMIO流程。正式应用须保留其他Job事件，不得像简单轮询样例一样丢弃；须完成source clean、dirty destination clean及完成后destination invalidate。fence不替代cache维护。

15 / TIMING

## 关键时序：一次 Submit，跨两个 Engine 并行执行

时间（逻辑阶段） | Tile0 | Tile1 | Scheduler | DMA0 | DMA1
T0 | 写 Shadow0 | 写 Shadow1 | — | IDLE | IDLE
T1 | SUBMIT → FIFO0 Job7 | SUBMIT → FIFO1 Job12 | 两个 FIFO 非空 | IDLE | IDLE
T2 | 准备 Job8 | 继续 CPU 程序 | Job7→DMA0；Job12→DMA1 | 锁存 Job7 | 锁存 Job12
T3 | CPU 独立执行 | CPU 独立执行 | Owner 锁定 | ND 展开多个 1D | ND 展开多个 1D
T4 | 查询/中断 | 查询/中断 | — | AXI DDR 读写 | AXI DDR 读写
T5 | 等待 Job7 | Job12 完成 | Completion → Tile1 | 仍在执行 | IDLE
T6 | Job7 完成 | 可提交后续 | Completion → Tile0 | IDLE | 可复用

### 三个时间点不应混淆

提交 Accepted

Job 进入每 Tile FIFO：CPU 的 MMIO Submit 已完成。

ND Input Accepted

最后一个 1D 子请求被 Backend 接收，不代表 DDR 写完。

ND Job Completed

最终 ND Response 返回，Completion 记录后可向 CPU 通知。

16 / VERIFICATION

## 验证矩阵与交付边界

验证场景 | 核心检查
参数化N/M与单路、奇数数量 | 无零位宽，RR索引正确，前后端数量独立
多Tile并发MMIO与Shadow改写 | 隔离CSR，保持已提交快照
二维步长和非对齐复制 | 逐字节检查所有行及目标边界
跨4KiB大块复制 | 修正legalizer后数据正确，检查AR/AW不跨4KiB
最终B反压 | 最终写响应前不得完成或释放Owner
非法长度、重复数、高位、范围、重叠 | 提交拒绝，不分配ID或完成事件
Job FIFO满与Completion容量满 | 返回SLVERR，CPU仍可读完成，不丢任务
不同Engine乱序完成 | Tile/Job归属正确，同Tile按序执行
R/B错误与后续行 | 正常排空、锁存错误、一次最终完成
CPU/DMA共享DDR及全局AMO/LRSC | ID路由、reservation隔离、跨源写使SC失败
活动/排队任务协调复位 | DDR接收前清除内部在途任务；物理DDR在途清除另需平台验证
独立Tile/Engine复位、超时取消 | 首版不支持，不能仅用generation代替事务排空
CPU Cache、FPGA综合及板级DDR | 目标平台尚须验证，RTL仿真不等价于板级通过

### 实施顺序

012 Tile + 1 DMA先证明多入口配置隔离、Job 原子快照、来源 ID 正确。

022 Tile + 2 DMA补 Scheduler + Engine Holding + Completion Router，验证真实并行。

034 Tile + 2 DMA压力测试 MMIO 并发、RR 公平、DDR 仲裁、错误/复位。

04N Tile + M DMA统一参数化/typedef、QoS、性能计数器、完成乱序扩展。

17 / COMPARISON

## 与“完整原始 DMA + Programmer”方案对比

特征 | 方案 A：两级 MMIO + 原始完整 DMA | 方案 B：一次 MMIO + 直接 ND Job
CPU 配置外层 CSR | 有 | 有
Scheduler 到 Engine | 硬件再对原始 DMA 执行 10+ MMIO 写/读 | 直接传送 `idma_nd_req_t`；无第二级 MMIO
执行端寄存器 Frontend | 每个原始 DMA 保留 | M 个执行 Engine 无重复 Frontend
原始 Midend / Backend | 原样 | 原样
提交控制延迟 | 额外的 AXI MMIO 编程状态机 | 直接硬件 valid/ready
新增复杂性 | M 个 AXI Programmer + 任务跟踪 | ND Holding/完成跟踪/CSR 转换
小 Job 吞吐 | 较易被二次配置限制 | 通常更合适
硬件模块封装侵入度 | 最低 | 需要重组 `cheshire_idma_wrap` 功能边界

决策：把 Scheduler 对 Engine 的接口固定为完整 tagged_job_t + Completion。方案 B 直接对 ND Midend 输入，后端不需要任何二次 MMIO。这样即使未来换 Engine 实现，也不用重写 CPU CSR 与 Scheduler。

18 / REFERENCES

## 源码依据与版本边界

本设计基于指定分支的源码分析，避免将最新 iDMA 主分支的寄存器映射误用到旧版。所有链接均指向指定分支或固定 Git commit。

Cheshire DMA Wrapper前端/FIFO/ND/Backend 连接及参数GitHub ↗ (https://github.com/pulp-platform/cheshire/blob/mp/ara-pulp-v2/hw/cheshire_idma_wrap.sv)Cheshire SoC portsExternal AXI 与 LLC DDR 主端口GitHub ↗ (https://github.com/pulp-platform/cheshire/blob/mp/ara-pulp-v2/hw/cheshire_soc.sv)Cheshire packageCfg.Dma、外部 AXI 映射、LLC 开关GitHub ↗ (https://github.com/pulp-platform/cheshire/blob/mp/ara-pulp-v2/hw/cheshire_pkg.sv)Cheshire iDMA register C header旧版寄存器偏移与 CONF 位域GitHub ↗ (https://github.com/pulp-platform/cheshire/blob/mp/ara-pulp-v2/sw/include/regs/idma.h)iDMA register template读 NEXT_ID 提交、Shadow 转 ND 请求GitHub ↗ (https://github.com/pulp-platform/iDMA/blob/c12caf59bb482fe44b27361f6924ad346b2d22fe/src/frontend/reg/tpl/idma_reg.sv.tpl)iDMA ND Midend多维展开、ready/last/zero、最终响应GitHub ↗ (https://github.com/pulp-platform/iDMA/blob/c12caf59bb482fe44b27361f6924ad346b2d22fe/src/midend/idma_nd_midend.sv)iDMA multi-channel inst64多 ND Midend/Backend/RW Join 实例化参考GitHub ↗ (https://github.com/pulp-platform/iDMA/blob/c12caf59bb482fe44b27361f6924ad346b2d22fe/src/frontend/inst64/idma_inst64_top.sv)

交付范围：已有RTL、软件接口及可复现测试；单元检查见docs/shared_dma_verification.md。后续真实CVA6系统仿真已验证独立ELF启动、并发DMA、实际PLIC异常处理、WB缓存维护及软件AMO同步，步骤与证据见docs/shared_dma_system_verification.md及util/run_shared_dma_system.sh。本文接口草案并非实际源码。物理DDR复位、FPGA综合时序及板级验证仍需目标平台检查，系统保持非硬件一致性。

Cheshire · iDMA 0.6.3 + page-width修正 · 参数化共享DMA设计 · 2026-10-12

↑ 返回顶部打印 / 保存 PDF
