imissyou6534/cheshire/docs/cva6_ara_soc_development_manual.html

# CVA6 + Ara SoC 外设配置与地址空间开发手册

对象工程：/home/user06/work/xinkailai/cheshire。本文基于当前分支真实源码、Bender.lock 和已生成仿真/FPGA脚本整理，用于指导外设裁剪、地址修改、新增 Reg/AXI 外设和 Ara/FFT bring-up。

约束：本文是单文件 HTML，不依赖 CDN 或外部 JS；只新增文档，不修改 RTL/C/Makefile 等源文件。

## 1. 项目与版本

项目 | 当前源码确认 | 说明
工程目录 | /home/user06/work/xinkailai/cheshire | 服务器真实工程。
当前分支 | ara-vcu118 | 工作区存在未提交修改和新增 FFT 文件。
Cheshire 基线 | 5d38a03 target/xilinx: Add VCU118 flow (#240) | 当前 HEAD；工作区有本地改动。
CVA6 依赖 | Bender.lock: 99eac9a649001bdf5b8f9da52e0ca73d5c48db1c | checkout 目录为 .bender/git/checkouts/cva6-20c9d7cbe0dd6995。
Ara 依赖 | Bender.lock: 2895ba907e9eb14b3464609dc791a969d159a7c3 | checkout 目录为 .bender/git/checkouts/ara-2c7b103275a16c87。
FFT 新增源 | hw/fft/src/*.sv, hw/fft/rtl/*.v | 已加入 Bender.yml source list。

源码状态：本文把工作区未提交内容当成当前工程事实分析，但不改变它们。所有“建议修改”都只是手册说明，不代表本文已执行。

## 2. SoC 总体架构

源码确认：hw/cheshire_soc.sv 是 SoC 顶层；target/xilinx/src/cheshire_top_xilinx.sv 是 VCU118/VCU128/Genesys2 板级顶层。CVA6、Debug、DMA、Ara、FFT、VGA、USB 等作为 AXI master 或 slave 接入主 AXI crossbar；UART/SPI/I2C/GPIO/CLINT/PLIC 等普通控制外设位于 AXI-to-Reg 后面的 Regbus demux。

### AXI Master

CVA6 core、Debug SBA、Ara、FFT、DMA、VGA、USB、Serial Link RX、external AXI master。

### AXI Slave

Debug Module AXI slave、Reg demux window、LLC/SPM/DRAM path、DMA config、Serial Link TX、external AXI slave。

### Regbus Slave

Boot ROM、CLINT、PLIC、SoC regs、LLC regs、UART、I2C、SPI、GPIO、VGA cfg、USB cfg、BusErr、CLIC、external reg slave。

### CPU 紧耦合加速器

Ara 与 FFT 复用 CVA6 accelerator 接口；Ara 不是 MMIO 外设，FFT 也不是 MMIO 外设。

## 3. CVA6 + Ara 架构

源码确认：hw/cheshire_pkg.sv: gen_cva6_cfg() 设置 ret.RVV = cfg.Ara | cfg.Fft，同时 ret.CvxifEn = 0。在当前 pin 住的 CVA6 中，core/include/build_config_pkg.sv:23-24,100 用 RVV 派生 EnableAccelerator 和第 5 个写回端口，因此 Ara/FFT 走的是 CVA6 的 accelerator/RVV 路径，不依赖 CvxifEn。

源码确认：Ara 顶层 .bender/git/checkouts/ara-*/hardware/src/ara.sv 暴露 acc_req_i/acc_resp_o 和 AXI master。Cheshire 中 AraDataWideWidth = 32 * Cfg.AraNrLanes；当前 VCU118 和仿真 Ara 配置为 AraNrLanes=2，因此 Ara wide AXI 数据宽度为 64 bit，与 Cheshire AxiDataWidth=64 相同，但代码仍保留 axi_dw_converter。

源码确认：Ara checkout 中 hardware/src/cva6_accel_first_pass_decoder.sv 当前识别普通 RVV 指令，还额外识别 FFT custom 指令：OpcodeCustom0/funct3=101/log2N=12 和 0x0000002b wait 指令。

## 4. Cheshire 配置系统

配置中心是 hw/cheshire_pkg.sv。核心结构是 cheshire_cfg_t，默认值是 DefaultCfg，派生函数包括 gen_axi_in()、gen_axi_out()、gen_reg_out()、gen_cva6_cfg()。

字段 | 类型/默认 | 作用 | 影响 RTL | 影响地址/端口/中断/软件 | 修改同步检查
NumCores | bit[4:0] / 1 | CVA6 hart 数 | 生成 core loop、CLINT/PLIC contexts、BusErr core units | AXI master 数、中断 hart 数、软件 hart ID | CLINT、PLIC、boot code、SMP 软件、Ara 限制
AddrWidth | aw_bt / 48 | AXI/Regbus 地址宽度 | 所有 addr_t 类型 | 地址 map、CVA6 config、外设连接 | CVA6 PLEN/VLEN 属性、外部 AXI 类型
AxiDataWidth | dw_bt / 64 | SoC AXI 数据宽度 | AXI typedef、LLC、DMA、bridges | Ara converter、FFT DataWidth、软件数据打包 | LLC size、FFT task ctrl assert、DDR wrapper
Bootrom | bit / 1 | Boot ROM | if (Cfg.Bootrom) | Reg map bootrom；boot addr | boot flow、linker、ROM image
Uart | bit / 1 | UART 16550 类接口 | 实例化 reg_uart_wrap | Reg map 0x0300_2000；IRQ | linker、DTS、console、FPGA pins
I2c | bit / 1 | OpenTitan I2C | 实例化 i2c | Reg map 0x0300_3000；多 IRQ | HAL/DIF、board pins、pullups
SpiHost | bit / 1 | OpenTitan SPI Host | 实例化 spi_host | Reg map 0x0300_4000；IRQ | flash/SD boot、STARTUPE3/board pins
Gpio | bit / 1 | OpenTitan GPIO | 实例化 gpio | Reg map 0x0300_5000；32 IRQ | DTS、board pins
Dma | bit / 1 | iDMA | 实例化 cheshire_idma_wrap | AXI master + AXI cfg slave 0x0100_0000；BusErr IRQ | AXI user/ID、software DMA driver
SerialLink | bit / default 1, Xilinx 0 | chip-to-chip AXI serial link | 实例化 serial_link | AXI master/slave + Reg cfg + address region | board pins、slink address domain
Vga | bit / 1 | AXI VGA | 实例化 axi_vga | AXI master + Reg cfg 0x0300_7000 | framebuffer, board pins, BusErr
Usb | bit / default 1, VCU118 0 | USB OHCI | 实例化 spinal_usb_ohci | AXI master + Reg cfg 0x0300_8000；IRQ | PHY clock/pins, 32-bit DMA domain
AxiRt | bit / 0 | AXI traffic regulation | 实例化 axi_rt_unit_top | Reg map 0x020c_0000 | manager count、budget config
Clic | bit / 0 | per-core CLIC | 每 core 生成 clic | Reg map 0x0800_0000 + i*0x40000 | CVA6 RVSCLIC、interrupt software
IrqRouter | bit / 0 | 中断动态路由 | 实例化 irq_router | Reg map 0x0208_0000 | PLIC/CLIC/外部目标中断规划
BusErr | bit / 1 | UNBENT bus error recorder | core/dma/vga units | Reg map 0x0300_9000 起；IRQ | 错误处理软件
Ara | bit / 0 | Ara vector accelerator | 实例化 Ara | 增加 AXI master；影响 CVA6 RVV/accelerator | Ara lanes/VLEN, tests, compiler flags
Fft | bit / 0 | 本分支 FFT accelerator | 实例化 router + FFT IP | 增加 AXI master；无 MMIO；影响 CVA6 RVV/accelerator | first-pass decoder、custom tests、构建宏
AraNrLanes | byte_bt / 2 | Ara lane 数 | Ara 参数 | Ara AXI 宽度 32*lanes | VLEN、资源、converter、tests
AraVLEN | word_bt / 2048 | Ara vector length bits | Ara 参数 | VRF size、软件 vlenb | compiler/runtime RVV assumptions
LlcNotBypass | bit / 1 | 实例化 LLC 而非 bypass | LLC/SPM 生成 | SPM cached/uncached map | bootrom SPM use, linker
LlcOutConnect | bit / 1 | 连接 LLC 外部 master | DRAM 端口 | DRAM address region | DDR wrapper, testbench DRAM model
LlcOutRegionStart/End | doub_bt / 0x8000_0000..0x1_0000_0000 | DRAM/LLC out 地址 | AXI map + CVA6 attrs | DRAM 地址、cacheable/executable | linker, DTS, OpenSBI, preload
AxiExtNumMst/Slv/Rules | 0 by default | 外部 AXI manager/slave 扩展 | 增加 AXI ports/rules | 端口数、地址 map | top-level wiring, cacheability
RegExtNumSlv/Rules | 0 by default | 外部 Regbus slave 扩展 | 增加 reg ports/rules | 二级 Reg map；同时一级 AXI map 指向 reg_demux | top-level wiring, software base
NumExtInIntrs | 0 by default | 外部中断输入数 | 同步器和 interrupt vector 宽度 | PLIC/CLIC/Router 输入源 | 外设 IRQ wiring, DTS interrupt spec

## 5. AXI Master/Slave 架构

gen_axi_in() 根据启用的 manager 生成 input/slave-side ports；gen_axi_out() 根据内部 slave 和外部 rule 生成 output/master-side ports。

类型 | 端口来源 | 说明
AXI managers | cores, debug, Ara, FFT, DMA, SerialLink, VGA, USB, external masters | 进入 axi_in_req[AxiIn.*]。
AXI slaves | debug, reg_demux, LLC/SPM/DRAM, DMA cfg, SerialLink, external slaves | 由 axi_out_req[AxiOut.*] 驱动。
ID width | AxiSlvIdWidth = Cfg.AxiMstIdWidth + $clog2(AxiIn.num_in) | crossbar 给 slave side 扩展 manager ID。
数据/地址宽度 | AxiDataWidth=64, AddrWidth=48 | 当前默认和 VCU118 配置沿用。

// 源码位置: hw/cheshire_soc.sv
localparam axi_in_t   AxiIn   = gen_axi_in(Cfg);
localparam axi_out_t  AxiOut  = gen_axi_out(Cfg);
localparam addr_rule_t [AxiOut.num_rules-1:0] AxiMap = gen_axi_map();

axi_xbar #(...) i_axi_xbar (
  .slv_ports_req_i ( axi_rt_in_req ),
  .mst_ports_req_o ( axi_out_req   ),
  .addr_map_i      ( AxiMap        )
);

## 6. Register Bus 架构

Regbus 是 32-bit 控制总线，挂在 AXI crossbar 的 AxiOut.reg_demux 后面。路径是：

CVA6/Ara/DMA/Debug AXI master
  -> AXI Xbar
  -> AxiOut.reg_demux
  -> axi_riscv_atomics_structs
  -> axi_cut
  -> axi_to_reg_v2
  -> addr_decode(RegMap)
  -> reg_demux
  -> UART/SPI/I2C/GPIO/CLINT/PLIC/...

## 7. 当前外设列表

外设 | Enable 条件 | 实例化模块 | Bus/Index | IRQ | AXI master traffic | 关闭时行为
Boot ROM | Cfg.Bootrom | cheshire_bootrom | RegOut.bootrom | 无 | 无 | 无 rule，boot addr 改为 platform ROM
UART | Cfg.Uart | reg_uart_wrap | RegOut.uart | intr.intn.uart | 无 | TX/modem tie-off，IRQ=0，地址 rule 删除
I2C | Cfg.I2c | i2c | RegOut.i2c | 多路 I2C IRQ | 无 | IO enable=0，IRQ=0，地址 rule 删除
SPI Host | Cfg.SpiHost | spi_host | RegOut.spi_host | error/event | 无 | SCK/CS/SD tie-off，IRQ=0，地址 rule 删除
GPIO | Cfg.Gpio | gpio | RegOut.gpio | 32 GPIO IRQ | 无 | 输出/enable=0，IRQ=0，地址 rule 删除
DMA | Cfg.Dma | cheshire_idma_wrap | AxiOut.dma, AxiIn.dma | BusErr 可选 | 是 | 无 config rule，无 AXI master assignment
Serial Link | Cfg.SerialLink | serial_link | RegOut.slink, AxiOut.slink, AxiIn.slink | 由 IP 内部/配置决定 | 是 | DDR out/clk tie-off，rules 删除
VGA | Cfg.Vga | axi_vga | RegOut.vga, AxiIn.vga | BusErr 可选 | 是 | VGA pins=0，BusErr IRQ tie-off
USB | Cfg.Usb | spinal_usb_ohci | RegOut.usb, AxiIn.usb | intr.intn.usb | 是 | PHY outputs=0，IRQ=0，rules 删除
CLINT | 固定 | clint | RegOut.clint | mtip/msip | 无 | 不受 feature bit 关闭
PLIC | 固定 | rv_plic | RegOut.plic | xeip | 无 | 不受 feature bit 关闭
CLIC | Cfg.Clic | clic | RegOut.clic[i] | core-local | 无 | clic signals tie-off，rules 删除
IRQ Router | Cfg.IrqRouter | irq_router | RegOut.irq_router | 路由所有 interrupt | 无 | 直接 fanout 到 targets
BusErr | Cfg.BusErr | axi_err_unit_wrap | RegOut.bus_err[j] | cores/dma/vga errors | 监控已有 AXI | 对应 IRQ tie-off，rules 删除
Ara | Cfg.Ara | ara | AxiIn.ara | 通过 accelerator exception/resp | 是 | acc_resp_ara='0，无 AXI master
FFT | Cfg.Fft | multi_accel_router, fft_accelerator_ip | AxiIn.fft | 通过 accelerator exception/resp | 是 | Ara 直连 CVA6 accelerator，FFT req/rsp tie-off

## 8. 外设开关方法

不要直接修改 DefaultCfg。推荐写目标专用配置函数，从 DefaultCfg 复制后覆盖需要的字段，再在仿真或 FPGA 顶层选择它。

function automatic cheshire_cfg_t gen_my_cva6_ara_cfg();
  cheshire_cfg_t ret = DefaultCfg;

  ret.Ara        = 1;
  ret.AraNrLanes = 2;
  ret.AraVLEN    = 2048;

  ret.Bootrom    = 1;
  ret.Uart       = 1;
  ret.SpiHost    = 1;
  ret.Gpio       = 1;
  ret.Dma        = 0;
  ret.I2c        = 0;
  ret.SerialLink = 0;
  ret.Vga        = 0;
  ret.Usb        = 0;
  ret.AxiRt      = 0;
  ret.Clic       = 0;
  ret.IrqRouter  = 0;
  ret.BusErr     = 1;

  return ret;
endfunction

RTL feature enable 与 FPGA pin enable 不同：Cfg.I2c=0 会删除 I2C RTL 和地址 rule；没有定义 USE_I2C 只是板级顶层不暴露 I2C pad。若 Cfg.I2c=1 但 USE_I2C 未定义，内部 I2C 仍可能综合，只是 pin 在顶层适配中没有接到外部端口。

## 9. 完整地址空间

地址区间均为半开区间 [start, end)。下表使用 64-bit 形式；“可修改”表示可以通过 RTL/config 修改，但必须同步相关软件和属性。

模块 | Start Address | End Address | Size | Bus | Enable 条件 | 定义文件/函数 | 是否可修改
Debug | 64'h0000_0000_0000_0000 | 64'h0000_0000_0004_0000 | 256 KiB | AXI | 固定 | gen_axi_out() | 可，但影响 debug/halt/exception
DMA config | 64'h0000_0000_0100_0000 | 64'h0000_0000_0100_1000 | 4 KiB | AXI | Cfg.Dma | gen_axi_out() | 可
Boot ROM | 64'h0000_0000_0200_0000 | 64'h0000_0000_0204_0000 | 256 KiB | Reg | Cfg.Bootrom | gen_reg_out() | 可，需改 boot/link
CLINT | 64'h0000_0000_0204_0000 | 64'h0000_0000_0208_0000 | 256 KiB | Reg | 固定 | gen_reg_out() | 可，需改 SW/DTS
IRQ Router | 64'h0000_0000_0208_0000 | 64'h0000_0000_020c_0000 | 256 KiB | Reg | Cfg.IrqRouter | gen_reg_out() | 可
AXI RT | 64'h0000_0000_020c_0000 | 64'h0000_0000_0210_0000 | 256 KiB | Reg | Cfg.AxiRt | gen_reg_out() | 可
SoC registers | 64'h0000_0000_0300_0000 | 64'h0000_0000_0300_1000 | 4 KiB | Reg | 固定 | AmRegs, gen_reg_out() | 可，但不建议
LLC registers | 64'h0000_0000_0300_1000 | 64'h0000_0000_0300_2000 | 4 KiB | Reg | Cfg.LlcNotBypass | gen_reg_out() | 可
UART | 64'h0000_0000_0300_2000 | 64'h0000_0000_0300_3000 | 4 KiB | Reg | Cfg.Uart | gen_reg_out() | 可，见第 11 章
I2C | 64'h0000_0000_0300_3000 | 64'h0000_0000_0300_4000 | 4 KiB | Reg | Cfg.I2c | gen_reg_out() | 可
SPI Host | 64'h0000_0000_0300_4000 | 64'h0000_0000_0300_5000 | 4 KiB | Reg | Cfg.SpiHost | gen_reg_out() | 可
GPIO | 64'h0000_0000_0300_5000 | 64'h0000_0000_0300_6000 | 4 KiB | Reg | Cfg.Gpio | gen_reg_out() | 可
Serial Link regs | 64'h0000_0000_0300_6000 | 64'h0000_0000_0300_7000 | 4 KiB | Reg | Cfg.SerialLink | gen_reg_out() | 可
VGA regs | 64'h0000_0000_0300_7000 | 64'h0000_0000_0300_8000 | 4 KiB | Reg | Cfg.Vga | gen_reg_out() | 可
USB regs | 64'h0000_0000_0300_8000 | 64'h0000_0000_0300_9000 | 4 KiB | Reg | Cfg.Usb | gen_reg_out() | 可
Bus Error regs | 64'h0000_0000_0300_9000 | 64'h0000_0000_0300_9000 + N*64 | 64 B each | Reg | Cfg.BusErr | gen_reg_out() | 可
PLIC | 64'h0000_0000_0400_0000 | 64'h0000_0000_0800_0000 | 64 MiB | Reg | 固定 | gen_reg_out() | 可，需改 SW/DTS
CLIC | 64'h0000_0000_0800_0000 | 64'h0000_0000_0804_0000 per core | 256 KiB/core | Reg | Cfg.Clic | gen_reg_out() | 可
SPM cached | 64'h0000_0000_1000_0000 | 64'h0000_0000_1002_0000 | 128 KiB 当前配置 | AXI/LLC | Cfg.LlcNotBypass | AmSpm, get_llc_size() | 可，见第 12 章
SPM uncached | 64'h0000_0000_1400_0000 | 64'h0000_0000_1402_0000 | 128 KiB 当前配置 | AXI/LLC | Cfg.LlcNotBypass | AmSpm + 0x0400_0000 | 可，需同步 alias
External on-chip | 64'h0000_0000_2000_0000 | 64'h0000_0000_8000_0000 | 参数化属性 | AXI ext | 需要 external rules | Cva6ExtCie*, ext maps | 可
DDR / LLC out | 64'h0000_0000_8000_0000 | 64'h0000_0001_0000_0000 | 2 GiB | AXI/LLC | Cfg.LlcOutConnect | LlcOutRegionStart/End | 可，见第 12 章
Serial Link region | 64'h0000_0001_0000_0000 | 64'h0000_0002_0000_0000 | 4 GiB | AXI | Cfg.SerialLink | SlinkRegionStart/End | 可
External Reg region | 由 RegExtRegionStart[k] | 由 RegExtRegionEnd[k] | 配置决定 | Reg | RegExtNumRules>0 | gen_axi_out() + gen_reg_out() | 推荐扩展方式
External AXI slave region | 由 AxiExtRegionStart[k] | 由 AxiExtRegionEnd[k] | 配置决定 | AXI | AxiExtNumRules>0 | gen_axi_out() | 推荐扩展方式

## 10. 地址译码原理

一级 AXI map 在 gen_axi_out() 中生成。它只知道大类：Debug、Regbus window、LLC/SPM/DRAM、DMA config、Serial Link、external AXI slave。普通外设并不是 AXI crossbar 的直接输出，而是共享 AxiOut.reg_demux。

二级 Reg map 在 gen_reg_out() 中生成。它把 0x0200_0000..0x0c00_0000 中的具体窗口分给 BootROM、CLINT、UART、PLIC 等。

为什么 UART 经过两级：CVA6 发 AXI 请求到 0x0300_2000；AXI xbar 看到该地址落在 0x0200_0000..0x0c00_0000，送到 AXI-to-Reg；Regbus addr_decode 再按 0x0300_2000..0x0300_3000 选择 RegOut.uart。

## 11. 修改外设地址

### 情况 1：UART 从 0x0300_2000 改到 0x0301_0000

若新地址仍在一级 Regbus window 0x0200_0000..0x0c00_0000 内，只需改二级 Reg map 和软件符号。

// hw/cheshire_pkg.sv, gen_reg_out()
if (cfg.Uart) begin
  i++; ret.uart = i; r++;
  ret.map[r] = '{i, 64'h0301_0000, 64'h0301_1000};
end

同步检查：

- sw/link/common.ldh: __base_uart
- 裸机 headers / tests 是否硬编码 UART 地址
- device tree / OpenSBI / Linux console，如果当前系统使用它们
- testbench/VIP 是否假设旧 UART 地址
- 无需改 cheshire_soc.sv，因为实例仍接 reg_out_req[RegOut.uart]

### 情况 2：UART 移到 0x4000_0000

仅改 gen_reg_out() 不够，因为一级 AXI xbar 默认不会把 0x4000_0000 送到 Regbus。必须让 gen_axi_out() 也有一条规则，把 0x4000_0000..0x4000_1000 路由到 AxiOut.reg_demux。

// 示例思路：一级把新 UART 窗口送到 reg_demux
ret.map[r] = '{1, 64'h4000_0000, 64'h4000_1000}; // idx 1 == reg_demux

// 二级再把同一窗口送到 UART
ret.map[r] = '{ret.uart, 64'h4000_0000, 64'h4000_1000};

若地址落入 CVA6 external on-chip 或 DRAM 属性区，还要检查 gen_cva6_cfg() 中 NonIdempotent/Execute/Cached region，避免 MMIO 被错误 cache 或 speculative access。

## 12. 修改 DRAM/SPM 地址

### DRAM 从 0x8000_0000 改到 0x4000_0000

硬件入口是 Cfg.LlcOutRegionStart 和 Cfg.LlcOutRegionEnd。它们同时影响 gen_axi_out() 的 AXI map 和 gen_cva6_cfg() 的 executable/cacheable region。

ret.LlcOutRegionStart = 64'h4000_0000;
ret.LlcOutRegionEnd   = 64'h8000_0000; // 示例，大小自行规划

必须同步检查：sw/link/common.ldh 的 dram origin、OpenSBI payload 地址、Linux DTS memory node、bootloader preload、testbench DRAM model、CVA6 cached/executable attributes、PMP/boot ROM 是否假设旧 DRAM。

### SPM 地址修改

SPM 基址由 AmSpm = 0x1000_0000 控制，uncached alias 用 AmSpm + 0x0400_0000。大小由 get_llc_size(Cfg) 计算，当前默认 8 * 256 * 8 * 64 / 8 = 131072 bytes。

改 SPM 时同步检查：AmSpm、AmSpmBaseUncached、AmSpmRegionMask、sw/link/common.ldh 的 spm、boot ROM stack、FFT tests 中 SPM_UNCACHED_ALIAS、CVA6 cacheable/executable region。

## 13. 新增 Reg 外设

### 推荐方案 A：External Reg Slave

新增 my_timer，地址 0x0300_A000，4 KiB，一个 interrupt。优先使用 external reg slave，避免侵入 Cheshire core。

function automatic cheshire_cfg_t gen_my_cfg();
  cheshire_cfg_t ret = DefaultCfg;
  ret.RegExtNumSlv = 1;
  ret.RegExtNumRules = 1;
  ret.RegExtRegionIdx[0] = 0;
  ret.RegExtRegionStart[0] = 64'h0300_A000;
  ret.RegExtRegionEnd[0]   = 64'h0300_B000;
  ret.NumExtInIntrs = 1;
  return ret;
endfunction

顶层连接：reg_ext_slv_req_o[0]/reg_ext_slv_rsp_i[0] 接 my_timer 的 Regbus 端口；intr_ext_i[0] 接 timer IRQ。因为 gen_axi_out() 会把 external reg rules 也追加到一级 AXI map 并指向 reg_demux，所以 CPU/Ara/DMA/Debug 都能通过 AXI-to-Reg 访问它。

### 方案 B：做成 Cheshire 内建外设

需要修改源文件，本文不执行。流程：

- hw/cheshire_pkg.sv: cheshire_cfg_t 加 bit MyTimer，DefaultCfg 设默认，reg_out_t 加 index，gen_reg_out() 加地址 rule。
- hw/cheshire_soc.sv: if (Cfg.MyTimer) 实例化 my_timer，连接 reg_out_req[RegOut.my_timer] 和 IRQ。
- Bender.yml: 加 RTL source。
- hw/regs/cheshire_regs.hjson: 如需 feature detection，加 hw_features.my_timer 并重新运行 regtool。

## 14. 新增 AXI Slave

新增 1 MiB SRAM：0x4000_0000..0x4010_0000。推荐用 external AXI slave。

ret.AxiExtNumSlv = 1;
ret.AxiExtNumRules = 1;
ret.AxiExtRegionIdx[0] = 0;
ret.AxiExtRegionStart[0] = 64'h4000_0000;
ret.AxiExtRegionEnd[0]   = 64'h4010_0000;

连接 axi_ext_slv_req_o[0]/axi_ext_slv_rsp_i[0] 到 SRAM AXI slave。由于 AXI xbar connectivity 是全连接，CPU、Ara、FFT、DMA、Debug SBA 等 AXI managers 都可访问该 slave，除非你在 wrapper 额外限制。

Cacheability 不是 external AXI rule 自动决定的。若 SRAM 希望 cacheable/executable，必须检查 gen_cva6_cfg() 中 external on-chip CIE 切分或新增 CVA6 region 属性；否则按 non-idempotent/MMIO 处理。

## 15. 新增 AXI Master

推荐架构：CPU 通过 RegExt slave 控制 accelerator，accelerator 通过 AxiExt master 主动访问 DDR/SPM/SRAM，并通过 NumExtInIntrs 回报完成/错误。

ret.RegExtNumSlv = 1;
ret.RegExtNumRules = 1;
ret.RegExtRegionIdx[0] = 0;
ret.RegExtRegionStart[0] = 64'h0300_A000;
ret.RegExtRegionEnd[0]   = 64'h0300_B000;

ret.AxiExtNumMst = 1;
ret.NumExtInIntrs = 1;

连接关系：

reg_ext_slv_req_o[0] -> accelerator CSR regbus
accelerator CSR rsp  -> reg_ext_slv_rsp_i[0]
accelerator axi_req  -> axi_ext_mst_req_i[0]
axi_ext_mst_rsp_o[0] -> accelerator axi_rsp
accelerator irq      -> intr_ext_i[0]

普通 external AXI master 不天然与 CVA6 D-cache coherent。Ara 在 Cheshire 内部使用 axi_inval_filter 给 CVA6 L1D 发 invalidation；外部 NPU/FFT 若与 CPU 共享 cacheable DDR buffer，软件通常需要 flush/invalidate/fence，或硬件增加一致性/失效机制。

## 16. 中断系统

cheshire_int_intr_t 包含 bus_err、gpio[31:0]、usb、SPI、I2C 多路、uart 和 zero。NumExtInIntrs 增加外部 interrupt source，先经过同步器进入 intr.ext，再进入 PLIC/CLIC/IRQ router fanout。

新增外设若使用 External Reg Slave，推荐用 intr_ext_i 作为外部中断输入；若做成内建外设，则需要扩展 cheshire_int_intr_t 和中断控制器配置，侵入更大。

## 17. 仿真配置

target/sim/src/tb_cheshire_pkg.sv 当前已有 5 套配置：

SelectedCfg | 配置函数 | 说明
0 | DefaultCfg | 默认 Cheshire。
1 | gen_cheshire_rt_cfg() | AxiRt=1。
2 | gen_cheshire_clic_cfg() | Clic=1。
3 | gen_cheshire_ara_cfg() | Ara=1, lanes=2, VLEN=2048。
4 | gen_cheshire_ara_fft_cfg() | Ara + FFT，Fft=1。

fixture_cheshire_soc.sv 用 localparam cheshire_cfg_t DutCfg = TbCheshireConfigs[SelectedCfg] 选择 DUT 配置。VCS 脚本支持 SELCFG，例如 SELCFG=4 运行 Ara+FFT。

## 18. FPGA 配置

target/xilinx/src/cheshire_top_xilinx.sv 中 gen_cheshire_xilinx_cfg() 从 DefaultCfg 出发，覆盖 RtcFreq=1MHz、SerialLink=0、USB/ARA/FFT 宏。

宏/配置 | 含义 | 当前 VCU118 状态
TARGET_VCU118 | 启用 VCU118 板级参数 | 已在 add_sources.vcu118.tcl 定义
USE_DDR4, USE_QSPI, USE_STARTUPE3 | 板级 DDR4/QSPI 连接 | 由 phy_definitions.svh 定义
ARA | ret.Ara=1 | 当前 generated tcl 已定义
NR_LANES=2, VLEN=2048 | Ara 参数 | 当前 generated tcl 已定义
FFT_ACCEL | ret.Fft=1 | 源码支持，但当前 add_sources.vcu118.tcl 未定义
USE_I2C/USE_VGA/USE_USB | 板级 pin/port enable | VCU118 当前未定义这些宏

若目标是减少 FPGA LUT/FF/BRAM，应改 FPGACfg 里的 Cfg.I2c/Vga/Usb/Dma/Gpio 等 feature bit，而不是只移除 board pin 宏。

## 19. 软件同步修改

硬件修改 | 一定检查 | 视系统而定
MMIO 地址变化 | sw/link/common.ldh, bare-metal headers/tests | DTS、OpenSBI、Linux driver、U-Boot
DRAM 地址变化 | linker dram origin、preload 地址、boot ROM assumptions | Linux memory node、OpenSBI payload、reserved-memory
SPM 地址/大小变化 | linker spm、boot ROM stack、LLC init | tests 使用 uncached alias、DMA buffers
PLIC/CLINT/IRQ 变化 | interrupt IDs、bare-metal init | DTS interrupt-controller, Linux drivers
Ara/RVV 打开 | 编译器 ISA flags、vector tests、mstatus.VS | OS context switch 保存 vector state

当前源码无法从 Cheshire 仓库单独确认 OpenSBI/Linux DTS 的最终生成内容；若要改 Linux bring-up，需要继续检查 sw/deps/cva6-sdk 生成脚本、board DTS 和 boot image 构建产物。

## 20. Ara 特殊配置

源码确认：gen_cva6_cfg() 中 ret.RVV = cfg.Ara | cfg.Fft。CVA6 build_config_pkg.sv 中 EnableAccelerator = CVA6Cfg.RVV，因此当 Cfg.Ara=1 或 Cfg.Fft=1 时，CVA6 accelerator 通路应启用。

源码确认：ret.CvxifEn = 0。在当前 CVA6 版本中，这并不关闭 RVV/Ara accelerator 通路；它关闭的是另一套 CV-X-IF FU 路径。需要在 elaboration 中打印/检查 CVA6Cfg.RVV 和 CVA6Cfg.EnableAccelerator 最终值。

Ara 访存路径：RVV instruction -> CVA6 first pass decoder -> ACCEL scoreboard entry -> CVA6 accelerator interface -> Ara dispatcher -> sequencer/lane/VLSU -> Ara AXI -> invalidation filter -> width converter -> Cheshire AXI xbar -> LLC/SPM/DRAM。

MMU 路径：Ara 通过 acc_mmu_req/acc_mmu_resp 使用 CVA6 LSU 中的 accelerator MMU arbitration。FFT 当前在 multi_accel_router 中关闭 fft_req_o.acc_mmu_en 并清零 MMU response，因此 FFT 使用传入物理/系统地址，不走 Ara MMU 翻译路径。

## 21. 已发现问题

优先级 | 问题/观察 | 证据 | 建议
高 | VCU118 generated tcl 未定义 FFT_ACCEL | add_sources.vcu118.tcl 只有 ARA/NR_LANES/VLEN | 重新生成或修改构建 target，使 FPGA 综合真正设置 FPGACfg.Fft=1
高 | Ara checkout 的 first pass decoder 被本地修改，加入 FFT custom 指令识别 | .bender/git/checkouts/ara-*/hardware/src/cva6_accel_first_pass_decoder.sv | 确认该依赖改动是否可复现；不要只依赖 upstream Ara rev
中 | hw_features 没有 Ara/FFT bit | hw/regs/cheshire_regs.hjson 只到 bus_err | 如软件要 runtime probe，扩展 HJSON 并 regenerate
中 | VCU118 pin 宏与 SoC feature enable 不完全等价 | phy_definitions.svh vs DefaultCfg | 资源裁剪应改 Cfg.*，不是只关 board port

## 22. 推荐最小 CVA6 + Ara SoC

用于研究 CVA6 + Ara 时，建议保留 BootROM、UART、SPI Host、CLINT、PLIC、LLC/SPM、DDR、BusErr；关闭 I2C、DMA、SerialLink、VGA、USB、AXI RT、CLIC、IRQ Router。GPIO 可按板级调试需要保留或关闭。

function automatic cheshire_cfg_t gen_min_cva6_ara_cfg();
  cheshire_cfg_t ret = DefaultCfg;
  ret.Ara = 1;
  ret.AraNrLanes = 2;
  ret.AraVLEN = 2048;
  ret.I2c = 0;
  ret.Dma = 0;
  ret.SerialLink = 0;
  ret.Vga = 0;
  ret.Usb = 0;
  ret.AxiRt = 0;
  ret.Clic = 0;
  ret.IrqRouter = 0;
  return ret;
endfunction

精简后保留地址：Debug、BootROM、CLINT、SoC regs、LLC regs、UART、SPI、GPIO(若保留)、BusErr、PLIC、SPM cached/uncached、DRAM。

## 23. 修改影响矩阵

修改内容 | cheshire_pkg.sv | cheshire_soc.sv | tb config | FPGA top | HJSON | Bender | DTS/SW
关闭 UART | 配置函数设 Uart=0 | 已有 generate | 选配置 | 可移除 pin | 可选 | 否 | console 必改
修改 UART 地址 | 改 gen_reg_out() 或 ext rule | 通常否 | 验证 | 否 | 否 | 否 | base/DTS 必改
修改 DRAM 地址 | LlcOutRegion* / attrs | 否 | preload/DRAM model | DDR wrapper通常否 | 否 | 否 | linker/DTS/OpenSBI
打开 Ara | Ara=1, lanes/VLEN | 已有 generate | 选 cfg 3/4 | ARA 宏 | 可选 feature bit | Ara source 已有 | ISA flags/tests
修改 Ara lanes | AraNrLanes | converter 自动参数 | 测试 | NR_LANES | 否 | 否 | 性能/ABI测试
新增 Reg 外设 | 推荐 ext config；内建则改 | ext 不改；内建要改 | 选配置 | 接端口 | 内建 feature bit 可改 | 内建加 source | driver/base/IRQ
新增 AXI Slave | AxiExt* | 否 | 接模型 | 接端口 | 否 | 否 | DTS/cache attrs
新增 AXI Master | AxiExtNumMst | 否 | 接模型 | 接端口 | 否 | 外部模块由 wrapper 管 | CSR driver/cache mgmt
新增 IRQ | NumExtInIntrs | 通常否 | 接线 | 接线 | 内建时可能改 | 否 | PLIC/DTS/driver
新增 SoC CSR | 可选 | 连接 hw2reg/reg2hw | 验证 | 否 | 必须改并 regenerate | 否 | headers

## 24. Bring-up / 验证流程

### 编译/elaboration 验证

- 打印或查看 Cfg.Uart/I2c/Ara/Fft/Dma。
- 检查 AxiIn.num_in、AxiOut.num_out、RegOut.num_out 是否符合预期。
- 检查 CVA6Cfg.RVV 和 CVA6Cfg.EnableAccelerator。

### 地址验证

- 对每个 MMIO base 读写一个安全寄存器。
- 关闭的外设访问旧地址应得到 decode/error response 或 Reg error slave，不应静默访问其他设备。
- 验证 DRAM/SPM cached/uncached alias 的读写一致性。

### Ara 验证

1. vsetvli
2. vector ALU
3. vector load
4. vector store
5. Ara store 后 CVA6 scalar load，观察 invalidation/fence 行为
6. 跨页 vector load/store，观察 acc_mmu_req/resp

### FPGA 验证

综合报告中检查关闭的 UART/I2C/VGA/USB/DMA 是否减少 LUT/FF/BRAM；同时确认相关 top-level pin 被移除或 tie-off。只关闭 USE_* pin 宏不足以证明 RTL 被裁剪。

## 25. 开发 Checklist

- 先决定使用内建修改还是 External Reg/AXI 扩展；默认优先 external。
- 任何 MMIO 地址改动同时检查一级 AXI map 和二级 Reg map。
- 任何 DRAM/SPM 改动同时检查 CVA6 memory attributes 和软件 linker/DTS。
- 任何新增 AXI master 都制定 cache flush/invalidate 或硬件一致性策略。
- Ara/FFT 打开后确认 first pass decoder、CVA6Cfg.RVV、EnableAccelerator。
- FPGA 资源裁剪以 Cfg.* 为准，board pin 宏只负责端口暴露。
- 修改 HJSON 后重新运行 regtool，并同步软件 generated headers。
- 验证关闭设备旧地址不会误路由到其他设备。

## 26. Source Reference

文件 | 关键内容
hw/cheshire_pkg.sv | cheshire_cfg_t, DefaultCfg, gen_axi_in(), gen_axi_out(), gen_reg_out(), gen_cva6_cfg()
hw/cheshire_soc.sv | AXI xbar, Reg demux, LLC, CVA6, Ara, FFT, Debug, UART/I2C/SPI/GPIO/DMA/VGA/USB/interrupts
target/sim/src/tb_cheshire_pkg.sv | 仿真配置 0..4，含 Ara+FFT
target/sim/src/fixture_cheshire_soc.sv | DutCfg = TbCheshireConfigs[SelectedCfg]，DUT 外部端口 tie-off/VIP 连接
target/xilinx/src/cheshire_top_xilinx.sv | VCU118 FPGA config function，ARA/FFT_ACCEL 宏
target/xilinx/src/phy_definitions.svh | VCU118 board pin feature macros
target/xilinx/scripts/add_sources.vcu118.tcl | 当前 generated Vivado defines：有 ARA，无 FFT_ACCEL
Bender.yml, Bender.lock | 依赖版本 pin 和 RTL source list
.bender/git/checkouts/cva6-*/core/include/build_config_pkg.sv | EnableAccelerator = CVA6Cfg.RVV，CVA6 final config
.bender/git/checkouts/cva6-*/core/load_store_unit.sv | accelerator MMU arbitration
.bender/git/checkouts/ara-*/hardware/src/ara.sv | Ara top, acc interface, AXI master
.bender/git/checkouts/ara-*/hardware/src/cva6_accel_first_pass_decoder.sv | RVV + FFT custom first-pass decode
hw/fft/src/fft_accel_pkg.sv | FFT custom instruction namespace
hw/fft/src/multi_accel_router.sv | Ara/FFT accelerator request router
hw/fft/src/fft_accelerator_ip.sv | FFT command queue + AXI memory bridge
sw/link/common.ldh | bare-metal base symbols and memory origins
