imissyou6534/cheshire/hw/fft/rtl/fftifftmain.v

////////////////////////////////////////////////////////////////////////////////
//
// Filename:	fftifftmain.v
// {{{
// Project:	A General Purpose Pipelined FFT Implementation
//
// Purpose:	This is the main module in the General Purpose FPGA FFT
//		implementation.  As such, all other modules are subordinate
//	to this one.  This module accomplish a fixed size Complex FFT on
//	4096 data points.
//	The FFT is fully pipelined, and accepts as inputs two complex two's
//	complement samples per clock.
//
// Parameters:
//	i_clk	The clock.  All operations are synchronous with this clock.
//	i_reset	Synchronous reset, active high.  Setting this line will
//			force the reset of all of the internals to this routine.
//			Further, following a reset, the o_sync line will go
//			high the same time the first output sample is valid.
//	i_ce	A clock enable line.  If this line is set, this module
//			will accept two complex values as inputs, and produce
//			two (possibly empty) complex values as outputs.
//	i_left	The first of two complex input samples.  This value is split
//			into two two's complement numbers, 16 bits each, with
//			the real portion in the high order bits, and the
//			imaginary portion taking the bottom 16 bits.
//	i_right	This is the same thing as i_left, only this is the second of
//			two such samples.  Hence, i_left would contain input
//			sample zero, i_right would contain sample one.  On the
//			next clock i_left would contain input sample two,
//			i_right number three and so forth.
//	o_left	The first of two output samples, of the same format as i_left,
//			only having 23 bits for each of the real and imaginary
//			components, leading to 46 bits total.
//	o_right	The second of two output samples produced each clock.  This has
//			the same format as o_left.
//	o_sync	A one bit output indicating the first valid sample produced by
//			this FFT following a reset.  Ever after, this will
//			indicate the first sample of an FFT frame.
//
// Arguments:	This file was computer generated using the following command
//		line:
//
//		% ./fftgen -U -2 -f 4096 -n 16 -p 0 -d /tmp/cheshire-dual-runtime-20261019
//
//	This core will use hardware accelerated multiplies (DSPs)
//	for 0 of the 12 stages
//
// Creator:	Dan Gisselquist, Ph.D.
//		Gisselquist Technology, LLC
//
////////////////////////////////////////////////////////////////////////////////
// }}}
// Copyright (C) 2015-2024, Gisselquist Technology, LLC
// {{{
// This file is part of the general purpose pipelined FFT project.
//
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
// }}}
////////////////////////////////////////////////////////////////////////////////
//
//
`default_nettype	none
//
//
//
`ifndef CHESHIRE_FFT_COEFF_ROOT
`define CHESHIRE_FFT_COEFF_ROOT "../../../hw/fft/rtl"
`endif
// Keep i_inverse stable through the task, and reset before changing direction.
module fftifftmain(i_clk, i_reset, i_ce,
		i_inverse, i_left, i_right,
		o_left, o_right, o_sync);
	// The bit-width of the input, IWIDTH, output, OWIDTH, and the log
	// of the FFT size.  These are localparams, rather than parameters,
	// because once the core has been generated, they can no longer be
	// changed.  (These values can be adjusted by running the core
	// generator again.)  The reason is simply that these values have
	// been hardwired into the core at several places.
	localparam	IWIDTH=16, OWIDTH=23; // LGWIDTH=12;
	//
	input	wire				i_clk, i_reset, i_ce;
	//
	input	wire				i_inverse;
	input	wire	[(2*IWIDTH-1):0]	i_left, i_right;
	output	reg	[(2*OWIDTH-1):0]	o_left, o_right;
	output	reg				o_sync;


	// Outputs of the FFT, ready for bit reversal.
	wire				br_sync;
	wire	[(2*OWIDTH-1):0]	br_left, br_right;


	wire		w_s4096;
	// verilator lint_off UNUSED
	wire		w_os4096;
	// verilator lint_on  UNUSED
	wire	[33:0]	w_e4096, w_o4096;
	fftstage	#(
		// {{{
		.IWIDTH(IWIDTH),
		.CWIDTH(IWIDTH+4),
		.OWIDTH(17),
		.LGSPAN(10),
		.BFLYSHIFT(0),
		.OPT_HWMPY(0),
		.CKPCE(1),
		.COEFFILE({`CHESHIRE_FFT_COEFF_ROOT,"/cmem_e8192.hex"})
		// }}}
	) stage_e4096(
		// {{{
		.i_clk(i_clk),
		.i_reset(i_reset),
		.i_ce(i_ce),
		.i_inverse(i_inverse), .o_inverse(),
		.i_sync(!i_reset),
		.i_data(i_left),
		.o_data(w_e4096),
		.o_sync(w_s4096)
		// }}}
	);
	fftstage	#(
		// {{{
		.IWIDTH(IWIDTH),
		.CWIDTH(IWIDTH+4),
		.OWIDTH(17),
		.LGSPAN(10),
		.BFLYSHIFT(0),
		.OPT_HWMPY(0),
		.CKPCE(1),
		.COEFFILE({`CHESHIRE_FFT_COEFF_ROOT,"/cmem_o8192.hex"})
		// }}}
	) stage_o4096(
		// {{{
		.i_clk(i_clk),
		.i_reset(i_reset),
		.i_ce(i_ce),
		.i_inverse(i_inverse), .o_inverse(),
		.i_sync(!i_reset),
		.i_data(i_right),
		.o_data(w_o4096),
		.o_sync(w_os4096)
		// }}}
	);


	wire		w_s2048;
	// verilator lint_off UNUSED
	wire		w_os2048;
	// verilator lint_on  UNUSED
	wire	[35:0]	w_e2048, w_o2048;
	fftstage	#(
		// {{{
		.IWIDTH(17),
		.CWIDTH(21),
		.OWIDTH(18),
		.LGSPAN(9),
		.BFLYSHIFT(0),
		.OPT_HWMPY(0),
		.CKPCE(1),
		.COEFFILE({`CHESHIRE_FFT_COEFF_ROOT,"/cmem_e4096.hex"})
		// }}}
	) stage_e2048(
		// {{{
		.i_clk(i_clk),
		.i_reset(i_reset),
		.i_ce(i_ce),
		.i_inverse(i_inverse), .o_inverse(),
		.i_sync(w_s4096),
		.i_data(w_e4096),
		.o_data(w_e2048),
		.o_sync(w_s2048)
		// }}}
	);
	fftstage	#(
		// {{{
		.IWIDTH(17),
		.CWIDTH(21),
		.OWIDTH(18),
		.LGSPAN(9),
		.BFLYSHIFT(0),
		.OPT_HWMPY(0),
		.CKPCE(1),
		.COEFFILE({`CHESHIRE_FFT_COEFF_ROOT,"/cmem_o4096.hex"})
		// }}}

) 	stage_o2048(
		// {{{
		.i_clk(i_clk),
		.i_reset(i_reset),
		.i_ce(i_ce),
		.i_inverse(i_inverse), .o_inverse(),
		.i_sync(w_s4096),
		.i_data(w_o4096),
		.o_data(w_o2048),
		.o_sync(w_os2048)
		// }}}
	);

	wire		w_s1024;
	// verilator lint_off UNUSED
	wire		w_os1024;
	// verilator lint_on  UNUSED
	wire	[35:0]	w_e1024, w_o1024;
	fftstage	#(
		// {{{
		.IWIDTH(18),
		.CWIDTH(22),
		.OWIDTH(18),
		.LGSPAN(8),
		.BFLYSHIFT(0),
		.OPT_HWMPY(0),
		.CKPCE(1),
		.COEFFILE({`CHESHIRE_FFT_COEFF_ROOT,"/cmem_e2048.hex"})
		// }}}
	) stage_e1024(
		// {{{
		.i_clk(i_clk),
		.i_reset(i_reset),
		.i_ce(i_ce),
		.i_inverse(i_inverse), .o_inverse(),
		.i_sync(w_s2048),
		.i_data(w_e2048),
		.o_data(w_e1024),
		.o_sync(w_s1024)
		// }}}
	);
	fftstage	#(
		// {{{
		.IWIDTH(18),
		.CWIDTH(22),
		.OWIDTH(18),
		.LGSPAN(8),
		.BFLYSHIFT(0),
		.OPT_HWMPY(0),
		.CKPCE(1),
		.COEFFILE({`CHESHIRE_FFT_COEFF_ROOT,"/cmem_o2048.hex"})
		// }}}

) 	stage_o1024(
		// {{{
		.i_clk(i_clk),
		.i_reset(i_reset),
		.i_ce(i_ce),
		.i_inverse(i_inverse), .o_inverse(),
		.i_sync(w_s2048),
		.i_data(w_o2048),
		.o_data(w_o1024),
		.o_sync(w_os1024)
		// }}}
	);

	wire		w_s512;
	// verilator lint_off UNUSED
	wire		w_os512;
	// verilator lint_on  UNUSED
	wire	[37:0]	w_e512, w_o512;
	fftstage	#(
		// {{{
		.IWIDTH(18),
		.CWIDTH(22),
		.OWIDTH(19),
		.LGSPAN(7),
		.BFLYSHIFT(0),
		.OPT_HWMPY(0),
		.CKPCE(1),
		.COEFFILE({`CHESHIRE_FFT_COEFF_ROOT,"/cmem_e1024.hex"})
		// }}}
	) stage_e512(
		// {{{
		.i_clk(i_clk),
		.i_reset(i_reset),
		.i_ce(i_ce),
		.i_inverse(i_inverse), .o_inverse(),
		.i_sync(w_s1024),
		.i_data(w_e1024),
		.o_data(w_e512),
		.o_sync(w_s512)
		// }}}
	);
	fftstage	#(
		// {{{
		.IWIDTH(18),
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
	wire	[45:0]	w_e2, w_o2;
	laststage	#(
		// {{{
		.IWIDTH(22),
		.OWIDTH(23),
		.SHIFT(1)
		// }}}
	) stage_2(
		// {{{
		.i_clk(i_clk),
		.i_reset(i_reset),
		.i_ce(i_ce),
		.i_sync(w_s4),
		.i_left(w_e4), .i_right(w_o4),
		.o_left(w_e2), .o_right(w_o2),
		.o_sync(w_s2)
		// }}}
	);


	wire	br_start;
	reg	r_br_started;
	initial	r_br_started = 1'b0;
	always @(posedge i_clk)
	if (i_reset)
		r_br_started <= 1'b0;
	else if (i_ce)
		r_br_started <= r_br_started || w_s2;
	assign	br_start = r_br_started || w_s2;

	// Now for the bit-reversal stage.
	bitreverse	#(
		// {{{
		.LGSIZE(12),
		.WIDTH(23)
		// }}}
	) revstage (
		// {{{
		.i_clk(i_clk),
		.i_reset(i_reset),
		.i_ce(i_ce & br_start),
		.i_in_0(w_e2),
		.i_in_1(w_o2),
		.o_out_0(br_left),
		.o_out_1(br_right),
		.o_sync(br_sync)
		// }}}
	);


	// Last clock: Register our outputs, we're done.
	initial	o_sync  = 1'b0;
	always @(posedge i_clk)
	if (i_reset)
		o_sync  <= 1'b0;
	else if (i_ce)
		o_sync  <= br_sync;

	always @(posedge i_clk)
	if (i_ce)
	begin
		o_left  <= br_left;
		o_right <= br_right;
	end


endmodule
