imissyou6534/cheshire/hw/fft/rtl/fftstage.v

////////////////////////////////////////////////////////////////////////////////
//
// Filename:	fftstage.v
// {{{
// Project:	A General Purpose Pipelined FFT Implementation
//
// Purpose:	This file is (almost) a Verilog source file.  It is meant to
//		be used by a FFT core compiler to generate FFTs which may be
//	used as part of an FFT core.  Specifically, this file encapsulates
//	the options of an FFT-stage.  For any 2^N length FFT, there shall be
//	(N-1) of these stages.
//
//
// Operation:
// 	Given a stream of values, operate upon them as though they were
// 	value pairs, x[n] and x[n+N/2].  The stream begins when n=0, and ends
// 	when n=N/2-1 (i.e. there's a full set of N values).  When the value
// 	x[0] enters, the synchronization input, i_sync, must be true as well.
//
// 	For this stream, produce outputs
// 	y[n    ] = x[n] + x[n+N/2], and
// 	y[n+N/2] = (x[n] - x[n+N/2]) * c[n],
// 			where c[n] is a complex coefficient found in the
// 			external memory file COEFFILE.
// 	When y[0] is output, a synchronization bit o_sync will be true as
// 	well, otherwise it will be zero.
//
// 	Most of the work to do this is done within the butterfly, whether the
// 	hardware accelerated butterfly (uses a DSP) or not.
//
// Creator:	Dan Gisselquist, Ph.D.
//		Gisselquist Technology, LLC
//
////////////////////////////////////////////////////////////////////////////////
// }}}
// Copyright (C) 2015-2024, Gisselquist Technology, LLC
// {{{
// This file is part of the general purpose pipelined FFT project.
//
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
// }}}
////////////////////////////////////////////////////////////////////////////////
//
//
`default_nettype	none
//
module	fftstage #(
		// {{{
		parameter	IWIDTH=16,CWIDTH=20,OWIDTH=17,
		// Parameters specific to the core that should be changed when
		// this core is built ... Note that the minimum LGSPAN (the base
		// two log of the span, or the base two log of the current FFT
		// size) is 3.  Smaller spans (i.e. the span of 2) must use the
		// dbl laststage module.
		// Verilator lint_off UNUSED
		parameter	LGSPAN=10, BFLYSHIFT=0, // LGWIDTH=12
		parameter [0:0]	OPT_HWMPY = 1,
		parameter [0:0]	OPT_RUNTIME_INVERSE = 1,
		// Clocks per CE.  If your incoming data rate is less than 50%
		// of your clock speed, you can set CKPCE to 2'b10, make sure
		// there's at least one clock between cycles when i_ce is high,
		// and then use two multiplies instead of three.  Setting CKPCE
		// to 2'b11, and insisting on at least two clocks with i_ce low
		// between cycles with i_ce high, then the hardware optimized
		// butterfly code will used one multiply instead of two.
		parameter	CKPCE = 1,
		// The COEFFILE parameter contains the name of the file
		// containing the FFT twiddle factors
		parameter	COEFFILE="cmem_o8192.hex",
		// Verilator lint_on  UNUSED

`ifdef	VERILATOR
		parameter  [0:0]	ZERO_ON_IDLE = 1'b0
`else
		localparam [0:0]	ZERO_ON_IDLE = 1'b0
`endif // VERILATOR
		// }}}
	) (
		// {{{
		input	wire				i_clk, i_reset,
							i_ce, i_sync,
		input	wire				i_inverse,
		input	wire	[(2*IWIDTH-1):0]	i_data,
		output	reg	[(2*OWIDTH-1):0]	o_data,
		output	reg				o_sync,
		output	reg				o_inverse
		// }}}
	);

	// Local signal definitions
	// {{{
	// I am using the prefixes
	// 	ib_*	to reference the inputs to the butterfly, and
	// 	ob_*	to reference the outputs from the butterfly
	reg	wait_for_sync;
	reg	[(2*IWIDTH-1):0]	ib_a, ib_b;
	reg	[(2*CWIDTH-1):0]	ib_c;
	reg	ib_sync;

	reg	ib_inverse;

	reg	b_started;
	wire	ob_sync;
	wire	[1:0]			ob_aux;
	wire				ob_inverse;
	assign	ob_sync = ob_aux[0];
	assign	ob_inverse = ob_aux[1];
	wire	[(2*OWIDTH-1):0]	ob_a, ob_b;

	// cmem is defined as an array of real and complex values,
	// where the top CWIDTH bits are the real value and the bottom
	// CWIDTH bits are the imaginary value.
	//
	// cmem[i] = { (2^(CWIDTH-2)) * cos(2*pi*i/(2^LGWIDTH)),
	//		(2^(CWIDTH-2)) * sin(2*pi*i/(2^LGWIDTH)) };
	//
	reg	[(2*CWIDTH-1):0]	cmem [0:((1<<LGSPAN)-1)];
`ifdef	FORMAL
// Let the formal tool pick the coefficients
`else
	initial	$readmemh(COEFFILE,cmem);

`endif

	reg	[(LGSPAN):0]		iaddr;
	reg	[(2*IWIDTH-1):0]	imem	[0:((1<<LGSPAN)-1)];

	reg	[LGSPAN:0]		oaddr;
	reg	[(2*OWIDTH-1):0]	omem	[0:((1<<LGSPAN)-1)];

	wire				idle;
	reg	[(LGSPAN-1):0]		nxt_oaddr;
	reg	[(2*OWIDTH-1):0]	pre_ovalue;
	// }}}

	reg				invmem	[0:((1<<LGSPAN)-1)];
	reg				pre_oinverse;

	// wait_for_sync, iaddr
	// {{{
	initial wait_for_sync = 1'b1;
	initial iaddr = 0;
	always @(posedge i_clk)
	if (i_reset)
	begin
		wait_for_sync <= 1'b1;
		iaddr <= 0;
	end else if ((i_ce)&&((!wait_for_sync)||(i_sync)))
	begin
		//
		// First step: Record what we're not ready to use yet
		//
		iaddr <= iaddr + { {(LGSPAN){1'b0}}, 1'b1 };
		wait_for_sync <= 1'b0;
	end
	// }}}

	// Write to imem
	// {{{
	always @(posedge i_clk) // Need to make certain here that we don't read
	if ((i_ce)&&(!iaddr[LGSPAN])) // and write the same address on
		imem[iaddr[(LGSPAN-1):0]] <= i_data; // the same clk
	// }}}

	// ib_sync
	// {{{
	// Now, we have all the inputs, so let's feed the butterfly
	//
	// ib_sync is the synchronization bit to the butterfly.  It will
	// be tracked within the butterfly, and used to create the o_sync
	// value when the results from this output are produced
	initial ib_sync = 1'b0;
	always @(posedge i_clk)
	if (i_reset)
		ib_sync <= 1'b0;
	else if (i_ce)
	begin
		// Set the sync to true on the very first
		// valid input in, and hence on the very
		// first valid data out per FFT.
		ib_sync <= (iaddr==(1<<(LGSPAN)));
	end
	// }}}

	// ib_a, ib_b, ib_c, ib_inverse
	// {{{
	// Read the values from our input memory, and use them to feed
	// first of two butterfly inputs
	always	@(posedge i_clk)
	if (i_ce)
	begin
		// One input from memory, ...
		ib_a <= imem[iaddr[(LGSPAN-1):0]];
		// One input clocked in from the top
		ib_b <= i_data;
		// and the coefficient or twiddle factor
		if ((OPT_RUNTIME_INVERSE)&&(i_inverse))
			ib_c <= { cmem[iaddr[(LGSPAN-1):0]][(2*CWIDTH-1):CWIDTH],
				-$signed(cmem[iaddr[(LGSPAN-1):0]][(CWIDTH-1):0]) };
		else
			ib_c <= cmem[iaddr[(LGSPAN-1):0]];
		ib_inverse <= i_inverse;
	end
	// }}}

	// idle
	// {{{
	// The idle register is designed to keep track of when an input
	// to the butterfly is important and going to be used.  It's used
	// in a flag following, so that when useful values are placed
	// into the butterfly they'll be non-zero (idle=0), otherwise when
	// the inputs to the butterfly are irrelevant and will be ignored,
	// then (idle=1) those inputs will be set to zero.  This
	// functionality is not designed to be used in operation, but only
	// within a Verilator simulation context when chasing a bug.
	// In this limited environment, the non-zero answers will stand
	// in a trace making it easier to highlight a bug.
	generate if (ZERO_ON_IDLE)
	begin : GEN_ZERO_ON_IDLE
		reg	r_idle;

		initial	r_idle = 1;
		always @(posedge i_clk)
		if (i_reset)
			r_idle <= 1'b1;
		else if (i_ce)
			r_idle <= (!iaddr[LGSPAN])&&(!wait_for_sync);

		assign	idle = r_idle;

	end else begin : NO_IDLE_GENERATION

		assign	idle = 0;

	end endgenerate
	// }}}

	////////////////////////////////////////////////////////////////////////
	//
	// Instantiate the butterfly
	// {{{
	////////////////////////////////////////////////////////////////////////
	//
	//
// For the formal proof, we'll assume the outputs of hwbfly and/or
// butterfly, rather than actually calculating them.  This will simplify
// the proof and (if done properly) will be equivalent.  Be careful of
// defining FORMAL if you want the full logic!
`ifndef	FORMAL
	//
	generate if (OPT_HWMPY)
	begin : HWBFLY

		hwbfly #(
			// {{{
			.IWIDTH(IWIDTH),
			.CWIDTH(CWIDTH),
			.OWIDTH(OWIDTH),
			.CKPCE(CKPCE),
			.SHIFT(BFLYSHIFT)
			// }}}
		) bfly(
			// {{{
			.i_clk(i_clk), .i_reset(i_reset), .i_ce(i_ce),
			.i_coef( (idle && !i_ce) ? {(2*CWIDTH){1'b0}}:ib_c),
			.i_left( (idle && !i_ce) ? {(2*IWIDTH){1'b0}}:ib_a),
			.i_right((idle && !i_ce) ? {(2*IWIDTH){1'b0}}:ib_b),
			.i_aux(ib_sync && i_ce),
			.o_left(ob_a), .o_right(ob_b), .o_aux(ob_sync)
			// }}}
		);

	end else begin : FWBFLY

		butterfly #(
			// {{{
			.IWIDTH(IWIDTH),
			.CWIDTH(CWIDTH),
			.OWIDTH(OWIDTH),
			.CKPCE(CKPCE),
			.SHIFT(BFLYSHIFT),
			.AUX_WIDTH(2)
			// }}}
		) bfly(
			// {{{
			.i_clk(i_clk), .i_reset(i_reset), .i_ce(i_ce),
			.i_coef( (idle && !i_ce)? {(2*CWIDTH){1'b0}} :ib_c),
			.i_left( (idle && !i_ce)? {(2*IWIDTH){1'b0}} :ib_a),
			.i_right((idle && !i_ce)? {(2*IWIDTH){1'b0}} :ib_b),
			.i_aux({ ib_inverse, ib_sync && i_ce }),
			.o_left(ob_a), .o_right(ob_b), .o_aux(ob_aux)
			// }}}
		);

	end endgenerate
`else

	// Verilator lint_off UNDRIVEN
	(* anyseq *)    wire    [(2*OWIDTH-1):0]        f_ob_a, f_ob_b;
	(* anyseq *)    wire    f_ob_sync;
	// Verilator lint_on  UNDRIVEN

	assign  ob_sync = f_ob_sync;
	assign  ob_a    = f_ob_a;
	assign  ob_b    = f_ob_b;

`endif

	// }}}

	// oaddr, o_sync, b_started
	// {{{
	// Next step: recover the outputs from the butterfly
	//
	// The first output can go immediately to the output of this routine
	// The second output must wait until this time in the idle cycle
	// oaddr is the output memory address, keeping track of where we are
	// in this output cycle.
	initial oaddr     = 0;
	initial o_sync    = 0;
	initial b_started = 0;
	initial o_inverse = 0;
	always @(posedge i_clk)
	if (i_reset)
	begin
		oaddr     <= 0;
		o_sync    <= 0;
		o_inverse <= 0;
		// b_started will be true once we've seen the first ob_sync
		b_started <= 0;
	end else if (i_ce)
	begin
		o_sync <= (!oaddr[LGSPAN])?ob_sync : 1'b0;
		o_inverse <= (!oaddr[LGSPAN]) ? ob_inverse : pre_oinverse;
		if (ob_sync||b_started)
			oaddr <= oaddr + 1'b1;
		if ((ob_sync)&&(!oaddr[LGSPAN]))
			// If b_started is true, then a butterfly output
			// is available
			b_started <= 1'b1;
	end
	// }}}

	// nxt_oaddr
	// {{{
	always @(posedge i_clk)
	if (i_ce)
		nxt_oaddr[0] <= oaddr[0];
	generate if (LGSPAN>1)
	begin : WIDE_LGSPAN

		always @(posedge i_clk)
		if (i_ce)
			nxt_oaddr[LGSPAN-1:1] <= oaddr[LGSPAN-1:1] + 1'b1;

	end endgenerate
	// }}}

	// omem
	// {{{
	// Only write to the memory on the first half of the outputs
	// We'll use the memory value on the second half of the outputs
	always @(posedge i_clk)
	if ((i_ce)&&(!oaddr[LGSPAN]))
		omem[oaddr[(LGSPAN-1):0]] <= ob_b;
	// }}}

	// invmem
	// {{{
	always @(posedge i_clk)
	if ((i_ce)&&(!oaddr[LGSPAN]))
		invmem[oaddr[(LGSPAN-1):0]] <= ob_inverse;
	// }}}

	// pre_ovalue
	// {{{
	always @(posedge i_clk)
	if (i_ce)
		pre_ovalue <= omem[nxt_oaddr[(LGSPAN-1):0]];
	// }}}

	// pre_oinverse
	// {{{
	always @(posedge i_clk)
	if (i_ce)
		pre_oinverse <= invmem[nxt_oaddr[(LGSPAN-1):0]];
	// }}}

	// o_data
	// {{{
	always @(posedge i_clk)
	if (i_ce)
		o_data <= (!oaddr[LGSPAN]) ? ob_a : pre_ovalue;
	// }}}

////////////////////////////////////////////////////////////////////////////////
////////////////////////////////////////////////////////////////////////////////
////////////////////////////////////////////////////////////////////////////////
//
// Formal properties
// {{{
////////////////////////////////////////////////////////////////////////////////
////////////////////////////////////////////////////////////////////////////////
////////////////////////////////////////////////////////////////////////////////
`ifdef	FORMAL
	// Local (formal) declarations
	// {{{
	// An arbitrary processing delay from butterfly input to
	// butterfly output(s)
	// Verilator lint_off UNDRIVEN
	(* anyconst *) reg	[LGSPAN:0]	f_mpydelay;
	(* anyconst *)	reg	[LGSPAN:0]	f_addr;
	// Verilator lint_on  UNDRIVEN
	reg	[2*IWIDTH-1:0]			f_left, f_right;
	reg	[2*OWIDTH-1:0]	f_oleft, f_oright;
	reg	[LGSPAN:0]	f_oaddr;
	wire	[LGSPAN:0]	f_oaddr_m1 = f_oaddr - 1'b1;
	reg	f_output_active;
	// }}}


	always @(*)
		assume(f_mpydelay > 1);

	reg	f_past_valid;
	initial	f_past_valid = 1'b0;
	always @(posedge i_clk)
		f_past_valid <= 1'b1;

	always @(posedge i_clk)
	if ((!f_past_valid)||($past(i_reset)))
	begin
		assert(iaddr == 0);
		assert(wait_for_sync);
		assert(o_sync == 0);
		assert(oaddr == 0);
		assert(!b_started);
		assert(!o_sync);
	end

	////////////////////////////////////////////////////////////////////////
	//
	// Formally verify the input half, from the inputs to this module
	// to the inputs of the butterfly
	//
	////////////////////////////////////////////////////////////////////////
	//
	//

	// Let's  verify a specific set of inputs

	always @(posedge i_clk)
	if (!$past(i_ce) && !$past(i_ce,2) && !$past(i_ce,3) && !$past(i_ce,4))
		assume(!i_ce);

	always @(*)
		assume(f_addr[LGSPAN]==1'b0);

	always @(posedge i_clk)
	if ((i_ce)&&(iaddr[LGSPAN:0] == f_addr))
		f_left <= i_data;

	always @(*)
	if (wait_for_sync)
		assert(iaddr == 0);

	wire	[LGSPAN:0]	f_last_addr = iaddr - 1'b1;

	always @(posedge i_clk)
	if ((!wait_for_sync)&&(f_last_addr >= { 1'b0, f_addr[LGSPAN-1:0]}))
		assert(f_left == imem[f_addr[LGSPAN-1:0]]);

	always @(posedge i_clk)
	if ((i_ce)&&(iaddr == { 1'b1, f_addr[LGSPAN-1:0]}))
		f_right <= i_data;

	always @(posedge i_clk)
	if (i_ce && !wait_for_sync
		&& (f_last_addr == { 1'b1, f_addr[LGSPAN-1:0]}))
	begin
		assert(ib_a == f_left);
		assert(ib_b == f_right);
		assert(ib_c == cmem[f_addr[LGSPAN-1:0]]);
	end

	////////////////////////////////////////////////////////////////////////
	//
	// Formally verify the output half, from the output of the butterfly
	// to the outputs of this module
	//
	////////////////////////////////////////////////////////////////////////
	//
	//

	always @(*)
		f_oaddr = iaddr - f_mpydelay + {1'b1,{(LGSPAN-1){1'b0}} };

	assign	f_oaddr_m1 = f_oaddr - 1'b1;

	initial	f_output_active = 1'b0;
	always @(posedge i_clk)
	if (i_reset)
		f_output_active <= 1'b0;
	else if ((i_ce)&&(ob_sync))
		f_output_active <= 1'b1;

	always @(*)
		assert(f_output_active == b_started);

	always @(*)
	if (wait_for_sync)
		assert(!f_output_active);

	always @(*)
	if (f_output_active)
	begin
		assert(oaddr == f_oaddr);
	end else
		assert(oaddr == 0);

	always @(*)
	if (wait_for_sync)
		assume(!ob_sync);

	always @(*)
		assume(ob_sync == (f_oaddr == 0));

	always @(posedge i_clk)
	if ((f_past_valid)&&(!$past(i_ce)))
	begin
		assume($stable(ob_a));
		assume($stable(ob_b));
	end

	initial	f_oleft  = 0;
	initial	f_oright = 0;
	always @(posedge i_clk)
	if ((i_ce)&&(f_oaddr == f_addr))
	begin
		f_oleft  <= ob_a;
		f_oright <= ob_b;
	end

	always @(posedge i_clk)
	if ((f_output_active)&&(f_oaddr_m1 >= { 1'b0, f_addr[LGSPAN-1:0]}))
		assert(omem[f_addr[LGSPAN-1:0]] == f_oright);

	always @(posedge i_clk)
	if ((i_ce)&&(f_oaddr_m1 == 0)&&(f_output_active))
	begin
		assert(o_sync);
	end else if ((i_ce)||(!f_output_active))
		assert(!o_sync);

	always @(posedge i_clk)
	if ((i_ce)&&(f_output_active)&&(f_oaddr_m1 == f_addr))
		assert(o_data == f_oleft);

	always @(posedge i_clk)
	if ((i_ce)&&(f_output_active)&&(f_oaddr[LGSPAN])
			&&(f_oaddr[LGSPAN-1:0] == f_addr[LGSPAN-1:0]))
		assert(pre_ovalue == f_oright);

	always @(posedge i_clk)
	if ((i_ce)&&(f_output_active)&&(f_oaddr_m1[LGSPAN])
			&&(f_oaddr_m1[LGSPAN-1:0] == f_addr[LGSPAN-1:0]))
		assert(o_data == f_oright);

	// Make Verilator happy
	// {{{
	// Verilator lint_off UNUSED
	wire	unused_formal;
	assign unused_formal = &{ 1'b0, idle, ib_sync };
	// Verilator lint_on  UNUSED
	// }}}

`endif // FORMAL
// }}}
endmodule
