imissyou6534/cheshire/sw/tests/vector_helloworld.c

// Copyright 2024 ETH Zurich and University of Bologna.
// Licensed under the Apache License, Version 2.0, see LICENSE for details.
// SPDX-License-Identifier: Apache-2.0
//
// Matteo Perotti <mperotti@ethz.ch>
//
// Simple vector memcpy for Hello World!

#include "regs/cheshire.h"
#include "dif/clint.h"
#include "dif/uart.h"
#include "params.h"
#include "util.h"

#include "cheshire_util.h"
#include "vector_util.h"

unsigned char buf[64];

int main(void) {
    cheshire_start();
    enable_rvv();

    printf("ni hao a, 1017!\r\n");
    const unsigned char str[] = "Hello Vector World!\r\n";
    vuint8m1_t str_v;

    // Copy the hello world string to buf
    str_v = __riscv_vle8_v_u8m1(str, sizeof(str));
    __riscv_vse8_v_u8m1(buf, str_v, sizeof(str));
    __asm__ volatile ("fence iorw, iorw" ::: "memory");

    for (unsigned i = 0; i < sizeof(str); ++i) {
        if (buf[i] != str[i]) return 1;
    }

    // Print buf
    printf("%s", buf);

    cheshire_end();

    return 0;
}
