imissyou6534/cheshire/(commit log)

2026-09-29 target/xilinx: Add VCU118 flow (#240)
    * target/xilinx: Add VCU118 support
    * docs: Add VCU118 documentation
    * target/xilinx: Unify code shared between VCU boards
    * target/xilinx: Default on quad SPI to load bitstream faster
    * treewide: Review fixes and cleanup
    ---------
2026-10-13 feat: add configurable shared DMA pool and real CVA6 system verification
2026-10-15 feat: integrate private tile SPM and Ara UART verification
    Separate private SPM from shared DDR atomics, preserve cross-region CPU LR/SC semantics, and extend the Ara+FFT simulation profile. Add real-CVA6 private-SPM, SCRATCH, and vector hello regressions with actual UART output and independent positive/negative checks.
    Dependency checkout snapshots, retained on codex/shared-dma-spm-20261015 branches (Bender.lock stays on upstream revisions; existing preparation scripts reproduce the patches):
    axi_riscv_atomics: 196ded48a4575e0150a0e1c690319cbd246542bf
    idma: cf1a880e45cfba0d0e81291d55de7cf0d06ee60a
    opentitan_peripherals: fe36fabf04c1ec78b02b9c71b7a42d91fe064945
2026-10-15 feat: add VCU118 multi-tile FPGA top and functional verification
    Add a separate VCU118 board top with configurable tile/DMA counts (default 1x1), private SPM, Ara/FFT, tile-0 UART and chained JTAG. Preserve the original SoC entry; add dedicated constraints, DDR/JTAG reset synchronization, FFT coefficient paths, and synthesis-only build support.
    Verified 1x1 real-CVA6/Ara hello, UART ACK, DDR DMA and PLIC through the production DDR conversion/CDC wrapper with a vendor-IP model; checked 2x2 JTAG/UART links and Vivado 2024.2 RTL elaboration. Mapped synthesis, implementation and hardware operation were not run.
    Local dependency snapshots (Bender.lock remains unchanged): idma bf8443f7e1a0471aca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
2026-10-17 feat: unify ROM firmware and multi-tile FFT verification
    Link ROM loader and SPM application into one firmware with immutable ROM snapshots. Add common multi-tile VCS boot modes and DDR FFT accuracy checks. Protect prepared dependencies in Make, retire replaced tools, and document build commands and dependency HEADs. Include the current Ara Hello UART banner change.
2026-10-20 feat: implement mixed-width buses and dual-sample FFT
    Keep CPU and debug at 64 bits; use Ara4, FFT, tile/SPM and iDMA at 128 bits with a 256-bit shared fabric. Add burst-capable dual-sample FFT integration, verification workloads, and VID stall diagnosis.
    Preserve all 26 prepared dependency revisions, seven local commit bundles and exact patches, and 24 supplementary dependency files in deps/prepared. Existing dependency checkouts remain unchanged; VID is documented but not fixed.
    Validation: 41 Python tests completed (34 passed, 7 skipped); nine diagnostic control results and interface evidence verified; dependency bundles, archive contents and RTL fingerprint checked.
2026-10-21 feat: finalize multi-tile baseline and pin maintained IP forks
2026-10-22 feat: add ROM Ara self-tests and scalar mask regressions
    Add ROM-embedded arithmetic and memory tests with actual operands, results,
    scalar expectations and per-element UART verdicts. Check complete UART output
    and AXI result readback with independent host references.
    Add scalar mask boundary coverage and carry the Ara RTL fix as a portable
    patch. The prepared Ara checkout is committed separately as:
    a51caad9302cbf74ff4119f4ebac28a835b4ae3b
    Validation: five VCS regressions passed, including 1708 boundary cases and
    217 existing VID/mask cases per lane profile, the unchanged ROM application's
    48 cases / 328 checks, and 19 host/build tests. No FPGA rebuild or push.
2026-10-22 deps: pin Ara mask scalar fixes
