imissyou6534/cheshire/(notices)

Notices in the files:
hw/fft/rtl/qtrstage.v:
The pipelined FFT project is free software (firmware): you can redistribute
it and/or modify it under the terms of the GNU Lesser General Public License
License: LGPL, v3, as defined and found on www.gnu.org,
http://www.gnu.org/licenses/lgpl.html
